InMyPajamas/breadboard-bench/out/plates/PLATES.md

# Plates — Bambu Studio projects, one per stage

Generated by `python cad/plates.py`. Each `.3mf` opens with the H2S
0.4 machine, the 0.20mm Standard process and the plate's filament
already selected, every part in its gated print pose, and per-object
wall / infill / brim overrides applied.

## Verified through Studio — and three things to still eyeball

These projects are written directly rather than exported by Studio.
`python cad/plates.py --verify` slices every one through Studio's own
CLI and checks walls / infill / brim in the G-code it produces; the
last run is recorded at the end of this file. (It runs on the macOS
build and on Windows from 02.08; the 02.07 Windows CLI returned −2/−3
with no output.) A slice proves the *CLI* accepts the file and keeps
its settings. It proves nothing about the GUI, which loads the named
system preset and re-applies only the keys listed in
`different_settings_to_system` — plate 01 once opened at the stock
2 walls / 15% grid while the CLI sliced it at 3 / 100%. Nor can it
look at the arrangement for you, so on first open:

1. Open `01_tpu_regime.3mf`. Fifteen objects should land in one row.
   That is the canary for *does Studio accept the file at all*.
2. Open `06_din_rail.3mf` and read the right-hand sidebar: it must say
   **5 walls, 25% infill, brim outer-only 5 mm**. That is the canary
   for *did the settings survive the load* — the one part where a
   silent reset to the stock 2-wall default would actually cost you.
3. On `04_first_article_a.3mf`, right-click `rear_tie` → object
   settings. It should carry its own brim. That is the canary for
   *per-object overrides*.

If any of the three is wrong, say so — the generator is one file
(`cad/plates.py`) and a re-run is seconds. Two of its rules exist
because Studio 2.8 rejected the first cut: the header keys a preset
carries (`description`, `filament_id`) must not reach a project as
vectors, and solid parts must use `zig-zag` infill — `rectilinear` is
no longer a value 2.8 recognises and `grid` is refused at 100%.

A plate's own process is set to the most demanding structural regime
on it, and object overrides only relax from there — so a missed
override over-builds a part, it never under-builds one. Check the
override column against the object list in Studio before slicing.

## Contradictions these plates had to settle

Building a real plate forces a decision where two documents disagree.
Three did:

- **DIN rail brim.** README's per-part table says brim `no`; the build
  plan's stage 6 note says `5 mm brim`. The build plan is the working
  document, so the rail gets the brim.
- **Plate size.** README says the H2S plate is 350 × 320. The machine
  profile's own `printable_area` is **340 × 320**; packing uses 340.
- **Stage 9 weight.** The build plan's stage header says 91 g, but its
  own file list (19 + 39 + 16 + 16 + 18) sums to 108. The plate is
  108 g. The header is the error.

## 01 — TPU regime and every pad

*Stage 1 · TPU · 11 objects · 7 g solid-equivalent · packs into 242 × 20 mm*

**Proves:** FOOT_FIT, and how much TPU for AMS actually over-prints here.

Plate process: **3 walls · 100% infill · brim off**

| object | qty | walls | infill | brim | override |
|---|---|---|---|---|---|
| `tpu_block` | 1 | 3 | 100% | no | plate |
| `foot_pad_006` | 2 | 3 | 100% | no | plate |
| `foot_pad_012` | 2 | 3 | 100% | no | plate |
| `foot_pad_018` | 2 | 3 | 100% | no | plate |
| `foot_pad` | 4 | 3 | 100% | no | plate |

**By hand in Studio:**

1. Rail gaskets retired 2026-10-05: the four printed TPU rail pads this plate carried are replaced by eight bought 3 x 1 O-rings (plate 02c). The plate is printed history; the pads are gone from the build so the record stays and the object goes.
2. Run the roll through the AMS in the OUTERMOST slot -- shortest, straightest PTFE run.
3. Chamber heater OFF. Nothing on this plate wants heat soak.
4. No brim: on a 6 mm-wide pad a brim is worse than none.

## 02 — PLA gauges

*Stage 2 · PLA · 10 objects · 120 g solid-equivalent · packs into 291 × 134 mm*

**Proves:** Every PLA fit in the build, on 3-53 g parts instead of 21-87 g.

Plate process: **5 walls · 25% infill · brim off**

| object | qty | walls | infill | brim | override |
|---|---|---|---|---|---|
| `fit_coupon_frame` | 1 | 3 | 15% | no | wall_loops=3, sparse_infill_density=15% |
| `rail_stub` | 1 | 5 | 25% | no | plate |
| `ladder_station_stub` | 1 | 3 | 15% | no | wall_loops=3, sparse_infill_density=15% |
| `pilot_block` | 1 | 5 | 25% | no | plate |
| `foot_gauge` | 1 | 3 | 15% | no | wall_loops=3, sparse_infill_density=15% |
| `spigot_stub` | 1 | 3 | 15% | no | wall_loops=3, sparse_infill_density=15% |
| `tie_stub` | 1 | 3 | 15% | no | wall_loops=3, sparse_infill_density=15% |
| `rail_cap_615` | 1 | 3 | 100% | no | wall_loops=3, sparse_infill_density=100%, sparse_infill_pattern=zig-zag |
| `rail_cap_625` | 1 | 3 | 100% | no | wall_loops=3, sparse_infill_density=100%, sparse_infill_pattern=zig-zag |
| `rail_cap_635` | 1 | 3 | 100% | no | wall_loops=3, sparse_infill_density=100%, sparse_infill_pattern=zig-zag |

**By hand in Studio:**

1. rail_stub and pilot_block are set to the DIN rail's 5 walls / 25% on purpose -- a stub in the gauge regime cannot predict the rail.
2. Write every measured number down before slicing anything in stage 4.

## 02b — Plate 02 follow-up: rail stub lips-down, foot gauge v2

*Stage 2 · PLA · 2 objects · 21 g solid-equivalent · packs into 178 × 35 mm*

**Proves:** That the flipped pose prints a clean lip: plate 02's stub printed web-down and sagged strands off both lips.

Plate process: **5 walls · 25% infill · brim off**

| object | qty | walls | infill | brim | override |
|---|---|---|---|---|---|
| `rail_stub` | 1 | 5 | 25% | no | plate |
| `foot_gauge_v2` | 1 | 3 | 15% | no | wall_loops=3, sparse_infill_density=15% |

**By hand in Studio:**

1. FOOT GAUGE v2: no pad of the 006/012/018 trio would enter v1's 16.00 x 6.00 pockets, so the pocket is the variable. Five pockets, +0.10 to +0.50 on length and width, tagged 1-5 dimples. Test with a PRODUCTION pad (caliper it: 16.24 x 6.24), groove in, thumb only, then invert and shake. The winner is the smallest pocket that passes both.
2. RAIL STUB: lips on the bed, web up. No support, no brim.
3. Caliper the lip band before the slot test: 34.85 wide, 1.20 thick, the same at both ends and the middle.
4. Then rerun test 2 (rail slots), and keep this stub for the stage 3 clips -- they hook the same lips.

## 02l — Half-bay gauge: the small board's 100 mm of the real ladder

*Stage 2 · PLA · 1 objects · 27 g solid-equivalent · packs into 89 × 100 mm*

**Proves:** That the half board drops into ITS bay: datum pocket and peg at 198.19, slot at 251.70, the rear shoulder stepped out 0.8 for the narrower board. Cut from frame.py's deck_ladder, so it is exactly what plate 07 prints there.

Plate process: **3 walls · 15% infill · brim off**

| object | qty | walls | infill | brim | override |
|---|---|---|---|---|---|
| `half_bay_gauge` | 1 | 3 | 15% | no | plate |

**By hand in Studio:**

1. Drop the HALF board straight down: one tab into the exact pocket near the left end of the gauge, the other into the slot, its notch over the peg on the far rail. Do not slide.
2. Pass: rim down on the shelf both sides, no rock, about 0.4 of play across, a shove along the rail meets the pocket wall.
3. If it sits off-centre along the rail that is the unmeasured end-to-cleat distance, not a fault; note which way and how far.
4. Lies along Y with Seam position = Back, like the ladder.

## 02r — Rail stub on its own: the clip target for plate 03

*Stage 2 · PLA · 1 objects · 11 g solid-equivalent · packs into 40 × 35 mm*

**Proves:** Nothing new: a fresh 40 mm slice of the real DIN rail to snap plate 03's clips onto. The 02b stub was thrown away.

Plate process: **5 walls · 25% infill · brim off**

| object | qty | walls | infill | brim | override |
|---|---|---|---|---|---|
| `rail_stub` | 1 | 5 | 25% | no | plate |

**By hand in Studio:**

1. Lips on the bed, web up. No support, no brim. About 15 minutes.
2. It carries the rail's new M3 cap-head counterbores at one end; they are irrelevant to the clip test.
3. Hook each plate 03 clip over one lip and rock it down. One clip at a time: the stub is 40 long and a clip is 30 wide.

## 02c — O-ring rail gasket test

*Stage 2 · PLA · 1 objects · 14 g solid-equivalent · packs into 12 × 64 mm*

**Proves:** Whether a 3 x 1 mm O-ring around each rail screw can replace the printed TPU gasket, and how deep its gland must be: the TPU on hand (TPU for AMS, ~68D) is too hard to squash.

Plate process: **5 walls · 25% infill · brim off**

| object | qty | walls | infill | brim | override |
|---|---|---|---|---|---|
| `pilot_block_oring` | 1 | 5 | 25% | no | plate |

**By hand in Studio:**

1. Station 1 (one dimple): gland 0.80 deep, 20% squeeze. Station 2 (two dimples): 0.70 deep, 30%.
2. One 3 x 1 O-ring flat in the gland around each pilot, the rail_stub from plate 02b over them, two M3x16 csk driven alternately by hand.
3. Pass: the stub's web pulls down flat (0.05 feeler will not enter), backing one screw out a turn lifts the web, and the pilots still bite after three cycles. The winner becomes RAIL_PAD_D in frame.py.

## 02d — Two deck stations, and the stops to hold a board

*Stage 2 · PLA · 1 objects · 47 g solid-equivalent · packs into 178 × 89 mm*

**Proves:** Whether a board sits FLAT across two supports, and whether the ladder's 2 mm indexing teeth catch a deck stop at all -- they print as a ~0.4 mm ripple because their tips are thinner than one extrusion line.

Plate process: **3 walls · 15% infill · brim off**

| object | qty | walls | infill | brim | override |
|---|---|---|---|---|---|
| `deck_pair` | 1 | 3 | 15% | no | plate |

**By hand in Studio:**

1. Deck stops retired 2026-09-23: the board's own cleats locate it now (plates 02e-02k). This plate is printed history; its stops are gone from the build so the record stays and the object goes.
2. deck_pair is the real deck_ladder trimmed to its first two stations (plates centred 51 and 141), so every tooth and ledge is exactly what plate 07 will print.
3. The deck stops are PETG in the real build; printed here in PLA on purpose, to avoid a material swap. Tooth engagement is what is being tested, not the clip's flex.
4. Set a full-size board across both stations: it must sit flat with no rock. Then push a stop along the strip -- you should feel a step every 2 mm and it should resist a shove.
5. If the stop slides freely, the teeth need redrawing before plate 07, or replacing with sockets for the board's own cleats (4.42 wide, 2.09 proud, about 65 mm apart).

## 02e — Tooth gauge: how blunt does a tooth need to be?

*Stage 2 · PLA · 4 objects · 12 g solid-equivalent · packs into 138 × 46 mm*

**Proves:** Plate 02d's teeth barely catch and barely stand up. Same 2.0 pitch and 0.9 depth on all three strips; only the flat on top of each tooth changes.

Plate process: **3 walls · 15% infill · brim off**

| object | qty | walls | infill | brim | override |
|---|---|---|---|---|---|
| `tooth_gauge` | 1 | 3 | 15% | no | plate |
| `tooth_rider_1` | 1 | 3 | 15% | no | plate |
| `tooth_rider_2` | 1 | 3 | 15% | no | plate |
| `tooth_rider_3` | 1 | 3 | 15% | no | plate |

**By hand in Studio:**

1. 1 dot = flat 0.0, the profile drawn today (the control). 2 dots = 0.6, about 1.4 extrusion lines across the tip. 3 dots = 0.9, about 2.1 lines.
2. Each rider is the negative of its OWN strip, with the same 0.1 clearance frame.py uses. Match the dimples: rider 2 on strip 2.
3. Slide each rider along its strip. You want a felt step every 2 mm, a rider that resists a shove, and teeth that do not fold over when you push sideways on them.
4. The winner becomes TOOTH_TOP in frame.py. Both halves of the real joint call teeth(), so one change fixes the ladder and the deck stop together.

## 02f — Slot gauge: slide the board in by its own tab

*Stage 2 · PLA · 3 objects · 13 g solid-equivalent · packs into 196 × 6 mm*

**Proves:** Whether a slot down the rail can replace the indexing teeth entirely. The board's edge tab slides in and the slot's ROOF stops it lifting -- a 5.2 mm feature doing the work instead of a 0.9 mm tooth that prints short and folds.

Plate process: **3 walls · 15% infill · brim off**

| object | qty | walls | infill | brim | override |
|---|---|---|---|---|---|
| `slot_gauge_1` | 1 | 3 | 15% | no | plate |
| `slot_gauge_2` | 1 | 3 | 15% | no | plate |
| `slot_gauge_3` | 1 | 3 | 15% | no | plate |

**By hand in Studio:**

1. Slot heights against a 5.20 tab: 1 dot 5.4, 2 dots 5.6, 3 dots 5.8. Depth is 2.5 on all three against a 2.09 tab.
2. Slide a board's TAB edge into each from the end -- it cannot be dropped in from above, that is the whole point.
3. Wanted: slides without forcing, no slop up and down, and the board cannot be lifted out. Then hold the gauge and let the board hang from it -- does the slot carry it?
4. The winner sets the slot height for deck_rail. Tab spacing does not matter: the slot runs the full length, so the board can stop anywhere.

## 02g — Cradle gauge: drop the board in by its own tab and notch

*Stage 2 · PLA · 3 objects · 19 g solid-equivalent · packs into 88 × 65 mm*

**Proves:** The gap between the rails, for a board that DROPS IN rather than slides: one rail carries an open pocket its tab falls into, the other a peg that falls into the notch opposite.

Plate process: **3 walls · 15% infill · brim off**

| object | qty | walls | infill | brim | override |
|---|---|---|---|---|---|
| `cradle_gauge_1` | 1 | 3 | 15% | no | plate |
| `cradle_gauge_2` | 1 | 3 | 15% | no | plate |
| `cradle_gauge_3` | 1 | 3 | 15% | no | plate |

**By hand in Studio:**

1. One station each. Gaps against the board's 54.74 plain width: 1 dot 54.94, 2 dots 55.14, 3 dots 55.34.
2. Drop a board straight down into each, lining the tab up with the open pocket and the notch with the peg.
3. Wanted: drops in without forcing, does not rattle sideways, and cannot slide along once seated.
4. Neither feature holds the board DOWN -- both locate it and gravity does the rest. Judge whether that is enough.
5. The winner sets the rail gap. Then a skeletal full-length piece checks that two or three stations line up at once.

## 02h — Span gauge, and how wide a peg the notch will take

*Stage 2 · PLA · 1 objects · 8 g solid-equivalent · packs into 124 × 12 mm*

**Proves:** Which station spacing the board's tabs really sit at. With discrete pockets this decides everything -- a pocket is 4.37 wide, so 2 mm out and the second tab misses. Only a photo estimate of 69-71 exists.

Plate process: **3 walls · 15% infill · brim off**

| object | qty | walls | infill | brim | override |
|---|---|---|---|---|---|
| `peg_gauge` | 1 | 3 | 15% | no | plate |

**By hand in Studio:**

1. PRINTED 2026-09-20, and its span strips were WRONG -- all four bracketed 68.58 to 72.39 when the board's cleats sit at about 66.04. They have been re-cut on plate 02i. Only peg_gauge remains here, and its answer stands: PEG_W = 3.8.
2. Drop the board's TAB edge onto each strip. Only the one whose spacing matches will take both tabs at once; the others will seat one and miss the other.
3. If two strips both take it, the board has slop -- say which felt tighter.
4. Nothing but two pads and a spine on purpose: the least material that can hold two pockets a fixed distance apart.
5. peg_gauge rides along: five pegs 3.2 to 4.0 wide, 1 to 5 dimples. Lower a board's NOTCH edge onto each. The widest that drops in cleanly is the peg width -- and it shows where the notch's mouth really is, which is the one dimension on that side still being assumed.

## 02i — Cleat rework: the fixed cradle, and the span re-cut to 66.04

*Stage 2 · PLA · 7 objects · 31 g solid-equivalent · packs into 262 × 78 mm*

**Proves:** Everything still open on board retention, on one plate. 02g's cradles were severed by their own tape relief and printed as two loose rails; 02h's spans were all too wide, bracketing 68.58-72.39 when the board sits at 66.04.

Plate process: **3 walls · 15% infill · brim off**

| object | qty | walls | infill | brim | override |
|---|---|---|---|---|---|
| `cradle_gauge_1` | 1 | 3 | 15% | no | plate |
| `cradle_gauge_2` | 1 | 3 | 15% | no | plate |
| `cradle_gauge_3` | 1 | 3 | 15% | no | plate |
| `span_gauge_1` | 1 | 3 | 15% | no | plate |
| `span_gauge_2` | 1 | 3 | 15% | no | plate |
| `span_gauge_3` | 1 | 3 | 15% | no | plate |
| `span_gauge_slot` | 1 | 3 | 15% | no | plate |

**By hand in Studio:**

1. This plate replaces 02g and 02h. Do not print either of those: 02g was severed, 02h's spacing was wrong.
2. CRADLES, 1 to 3 dots: rail gaps 54.94 / 55.14 / 55.34 against the board's 54.74 plain width. Drop a board straight down, tab into the open pocket, notch onto the peg. The tightest one that seats flush without rattling sets the rail gap.
3. Each cradle is now ONE piece. The first version cut its tape relief the full depth of the floor, which severed the two rails, and trimesh's is_watertight passed it because two disjoint closed solids are each watertight.
4. SPANS, 1 to 3 dots: 64.77 / 66.04 / 67.31, half a hole pitch apart, bracketing the measured 66.13. The board has THREE cleats per edge at about 66, not two at about 71.
5. span_gauge_slot is the production candidate and has no dots: its first pocket is exact, its second is slotted 63.04 to 69.04. One pocket locates, the other only stops rotation, so a spacing error stops mattering. Notches across its top face mark every half hole pitch -- read off where the second tab lands and that IS the spacing, no caliper needed.
6. If the slotted one seats easily and a graded one does not, that settles the design: slot the second pocket and stop chasing the constant.

## 02j — Span, re-cut to the calipered 65.21

*Stage 2 · PLA · 4 objects · 12 g solid-equivalent · packs into 254 × 18 mm*

**Proves:** The last open constant. 02i's spans were cut around 66.04, off a photo; the caliper says 65.21, so none of them could fit. These bracket the real number 0.5 mm apart.

Plate process: **3 walls · 15% infill · brim off**

| object | qty | walls | infill | brim | override |
|---|---|---|---|---|---|
| `span_gauge_1` | 1 | 3 | 15% | no | plate |
| `span_gauge_2` | 1 | 3 | 15% | no | plate |
| `span_gauge_3` | 1 | 3 | 15% | no | plate |
| `span_gauge_slot` | 1 | 3 | 15% | no | plate |

**By hand in Studio:**

1. Pocket centres: 1 dot 64.71, 2 dots 65.21 (the caliper reading), 3 dots 65.71. Half a millimetre apart, because a pocket only has 0.3 of slack -- a coarser step cannot tell the right answer from a near miss.
2. Drop the board's TAB edge straight down so both tabs go for both pockets at once. Do not slide it along.
3. span_gauge_slot has no dots and is the production candidate: its first pocket is exact, its second slotted 62.21 to 68.21. One pocket locates the board, the other only stops it rotating, so a spacing error is absorbed rather than jamming the first tab.
4. Notches across the slotted pad's top face mark every half hole pitch; the deep one is 65.21. Where the second tab lands IS the spacing -- read it off instead of calipering again.
5. If the slotted strip seats and a graded one does not, that settles the design: slot the second pocket in deck_rail and stop chasing the constant.

## 02k — Ledge gauge: the recessed deck, one datum station and one slot

*Stage 2 · PLA · 1 objects · 33 g solid-equivalent · packs into 120 × 89 mm*

**Proves:** Storyboard panel 28 in plastic. The first 120 mm of the proposed deck -- both rails with their ledges cut down 1.2, the datum pocket and peg, the slot at station 2 and the plate at 52 -- so the real board can be dropped on it before frame.py is touched.

Plate process: **3 walls · 15% infill · brim off**

| object | qty | walls | infill | brim | override |
|---|---|---|---|---|---|
| `ledge_gauge` | 1 | 3 | 15% | no | plate |

**By hand in Studio:**

1. Built on the Mac from PLAN.md's numbers (cad/ledge_gauge.py), not exported from frame.py: it tests the design. The station stub coupon, cut from frame.py later, tests the code.
2. Drop the full board's LEFT end straight down: first tab into the pocket near the left end, second tab into the slot, notch over the peg on the far rail. Do not slide it along.
3. Pass: rim down on the 0.6 shelf both sides with no rock, tape clear of the relief floor and the plate, about 0.4 of play across, and a shove along the rail meets the pocket wall, not friction.
4. Nothing stands above the rail crown. If anything on a ledge reads as a wall, that is a build error, not the design.
5. Tap the result into ledge.html on the Checks tab.

## 02m — Camera calibration target: dot grid and staircase

*Stage 2 · PLA · 3 objects · 37 g solid-equivalent · packs into 226 × 90 mm*

**Proves:** Turns the 4K top-down camera into a measuring instrument: 84 dark dots on a 10 mm pitch at mat level for scale, tilt and lens distortion, and two drop-in cups that put dots at 5 and 20 mm for the camera height and lens centre. The side camera reads the step faces for its height scale.

Plate process: **3 walls · 15% infill · brim off**

| object | qty | walls | infill | brim | override |
|---|---|---|---|---|---|
| `cal_target` | 1 | 3 | 15% | no | plate |
| `cal_step5` | 1 | 3 | 15% | no | plate |
| `cal_step20` | 1 | 3 | 15% | no | plate |

**By hand in Studio:**

1. Print it in a LIGHT colour -- the holes work by showing the dark mat through them. Black PLA makes it useless.
2. Three flat parts, no bridges, no supports: the plate, and two open cups printed floor-down. After printing, flip each cup and drop it into its recess on the plate, open side down -- the short one at the left end, the tall one at the right. Their dotted faces then sit 5 and 20 mm above the plate.After printing, caliper the plate's long side (nominal 140.00) and its short side (90.00) and tap them into the sheet: the true pitch is scaled from those, everything else follows.
3. Lay it flat on the mat near the centre under the overhead camera, marker hole at the top right, and take one Screenshot (Source) at 4K. Then one shot where the side camera sees the staircase edge-on.

## 03 — PETG gauges

*Stage 3 · PETG · 2 objects · 39 g solid-equivalent · packs into 230 × 26 mm*

**Proves:** RAIL_FIT for clips, the latch chamfer decision, MAGNET_FIT.

Plate process: **3 walls · 15% infill · brim off**

| object | qty | walls | infill | brim | override |
|---|---|---|---|---|---|
| `fit_clips_petg` | 1 | 3 | 15% | no | plate |
| `magnet_gauge` | 1 | 3 | 15% | no | plate |

**By hand in Studio:**

1. Supports are ALREADY PAINTED on fit_clips_petg: under each clip's tooth and release tab, written into the file. Support is normal(manual), so nothing else is generated. Just slice; the preview should show a thin column inside each of the four clips and none on the magnet gauge.
2. PLA SUPPORT INTERFACE, three clicks (the file cannot carry it yet): 1. In Project Filaments click + and pick your PLA. 2. Process > Support > Support/raft interface: choose filament 2. 3. Studio offers to set the matching zero-gap settings: click Yes. PLA does not bond to PETG, so the tooth and tab faces come out clean. Expect a prime tower and about 2h 45m.
3. A filled relief slot is a dead latch. It has happened twice.

## 04 — First article A -- left frame, tie, caps

*Stage 4 · PLA · 4 objects · 49 g solid-equivalent · packs into 294 × 189 mm*

**Proves:** The first structural parts, and the mating part everything later needs.

Plate process: **4 walls · 25% infill · brim off**

| object | qty | walls | infill | brim | override |
|---|---|---|---|---|---|
| `end_frame` | 1 | 3 | 15% | no | wall_loops=3, sparse_infill_density=15% |
| `rear_tie` | 1 | 4 | 25% | no | plate |
| `rail_cap` | 2 | 3 | 100% | no | wall_loops=3, sparse_infill_density=100%, sparse_infill_pattern=zig-zag |

**By hand in Studio:**

1. Three regimes on one plate. Check each object's overrides in the object list before slicing (see the table below).
2. Do not slice end_frame_r until every check on this plate has passed.

## 05 — Right frame -- the mirror export

*Stage 5 · PLA · 1 objects · 27 g solid-equivalent · packs into 60 × 165 mm*

**Proves:** The mirror export, and closes the pair.

Plate process: **3 walls · 15% infill · brim off**

| object | qty | walls | infill | brim | override |
|---|---|---|---|---|---|
| `end_frame_r` | 1 | 3 | 15% | no | plate |

**By hand in Studio:**

1. end_frame_r is a genuinely different STL, not the same file twice. Its pose is Y+90 where the left frame is Y-90.

## 06 — The DIN rail

*Stage 6 · PLA · 1 objects · 74 g solid-equivalent · packs into 300 × 35 mm*

**Proves:** The first big part. Nothing downstream can compensate if it warps.

Plate process: **5 walls · 25% infill · brim off**

| object | qty | walls | infill | brim | override |
|---|---|---|---|---|---|
| `din_rail` | 1 | 5 | 25% | no | plate |

**By hand in Studio:**

1. Only print this after both frames have accepted the stub.
2. Same flow and seam settings the stage 2 stub used.

## 04x — Both end frames, reprinted with a solid post

*Stage 4 · PLA · 2 objects · 54 g solid-equivalent · packs into 132 × 165 mm*

**Proves:** Nothing new: the frames from plate 06x flexed at the post's lightening window (3 mm ribs over an 18 mm opening), so the window is closed and both frames print again (2026-10-08).

Plate process: **3 walls · 15% infill · brim off**

| object | qty | walls | infill | brim | override |
|---|---|---|---|---|---|
| `end_frame` | 1 | 3 | 15% | no | plate |
| `end_frame_r` | 1 | 3 | 15% | no | plate |

**By hand in Studio:**

1. Outer face down, no brim. Everything else from plate 06x (tie, caps, rail) is already printed and stays.

## 06x — Both frames, the tie, both caps and the rail -- one plate

*Stage 6 · PLA · 6 objects · 150 g solid-equivalent · packs into 300 × 267 mm*

**Proves:** Nothing new: plates 04, 05 and 06 together, because the user asked for the PLA Matte parts on one bed (2026-10-07). Same per-object walls and infill as the separate plates.

Plate process: **5 walls · 25% infill · brim off**

| object | qty | walls | infill | brim | override |
|---|---|---|---|---|---|
| `end_frame` | 1 | 3 | 15% | no | wall_loops=3, sparse_infill_density=15% |
| `end_frame_r` | 1 | 3 | 15% | no | wall_loops=3, sparse_infill_density=15% |
| `rear_tie` | 1 | 4 | 25% | no | wall_loops=4 |
| `rail_cap` | 2 | 3 | 100% | no | wall_loops=3, sparse_infill_density=100%, sparse_infill_pattern=zig-zag |
| `din_rail` | 1 | 5 | 25% | no | plate |

**By hand in Studio:**

1. This breaks the stop rule 'one of each part before its second copy' on purpose: if the left frame's mortise binds, the right frame is already printed too. Print plate 04 alone first if that risk matters more than the bed time.
2. The rail's eight counterbores carry a one-layer skin at the seat: push the M3x12 cap screw through it.
3. No brim anywhere. The frames print on their outer face, the rail lips-down, the caps top-face down.

## 07 — The deck ladder

*Stage 7 · PLA · 1 objects · 78 g solid-equivalent · packs into 89 × 294 mm*

**Proves:** Largest single print. Gated on board width, socket clearance and the tie's shrink.

Plate process: **3 walls · 15% infill · brim off**

| object | qty | walls | infill | brim | override |
|---|---|---|---|---|---|
| `deck_ladder` | 1 | 3 | 15% | no | plate |

**By hand in Studio:**

1. Shoulder to shoulder must read 288.00 and agree with the tie's shrink within 0.15.
2. The ladder lies along Y on purpose, with Seam position = Back: that puts every layer's seam at a rail end. Leave both alone; on Aligned the seams land in the board pockets.

## 07b — TPU production pads -- the 14 held back

*Stage 7 · TPU · 14 objects · 7 g solid-equivalent · packs into 305 × 6 mm*

**Proves:** Nothing. This is the balance of the 18 feet, released once FOOT_FIT is confirmed.

Plate process: **3 walls · 100% infill · brim off**

| object | qty | walls | infill | brim | override |
|---|---|---|---|---|---|
| `foot_pad` | 14 | 3 | 100% | no | plate |

**By hand in Studio:**

1. Do not print this until stage 2's foot_gauge has confirmed FOOT_FIT. If the constant moved, regenerate first.

## 07c — TPU pads for the side tray and side bin (4)

*Stage 7 · TPU · 4 objects · 2 g solid-equivalent · packs into 83 × 6 mm*

**Proves:** Nothing new: 07b's 14 went into the ladder, frames and rear tray; plate 01's 4 are not assumed to exist (user, 2026-10-09).

Plate process: **3 walls · 100% infill · brim off**

| object | qty | walls | infill | brim | override |
|---|---|---|---|---|---|
| `foot_pad` | 4 | 3 | 100% | no | plate |

**By hand in Studio:**

1. 2 under the side tray, 2 under the side bin, grooved face in.

## 07f — All 18 TPU feet, for a whole bench

*Stage 7 · TPU · 18 objects · 9 g solid-equivalent · packs into 305 × 18 mm*

**Proves:** 07b and 07c on one plate: the TPU file that goes with the whole-bench project (one project cannot hold a third filament yet).

Plate process: **3 walls · 100% infill · brim off**

| object | qty | walls | infill | brim | override |
|---|---|---|---|---|---|
| `foot_pad` | 18 | 3 | 100% | no | plate |

**By hand in Studio:**

1. Same regime as 07b: TPU 95A HF, slow walls, 4 top and bottom layers.
2. 14 go under the frames, ladder and tray; 4 under the side tray and bin.

## 08 — The rear tray

*Stage 8 · PLA · 1 objects · 65 g solid-equivalent · packs into 288 × 53 mm*

**Proves:** Last of the PLA structure, and the only part with a real cooling problem.

Plate process: **4 walls · 15% infill · brim off**

| object | qty | walls | infill | brim | override |
|---|---|---|---|---|---|
| `rear_tray` | 1 | 4 | 15% | no | plate |

**By hand in Studio:**

1. ~190 layers of two isolated fins. That is what the 8 s fan threshold and 100% part fan are for.
2. Before any rail screw: a csk dropped into each buttress pilot must stand at least 7.75 mm proud.

## 10m — Buried head-magnet coupons: how much skin still snaps

*Stage 10 · PETG · 2 objects · 7 g solid-equivalent · packs into 40 × 20 mm*

**Proves:** Whether a side magnet sealed in at a pause (0.3 head clearance + 0.45 / 0.65 / 0.85 skin) still docks the side parts, against today's open seat. Model: 29 / 25 / 22 % of contact pull.

Plate process: **3 walls · 15% infill · brim off**

| object | qty | walls | infill | brim | override |
|---|---|---|---|---|---|
| `skin_coupon_045` | 1 | 3 | 15% | no | plate |
| `skin_coupon_085` | 1 | 3 | 15% | no | plate |

**By hand in Studio:**

1. Pause at 8.0 mm is in the file. Drop one disc ON EDGE into the slot of each coupon (1 nub = 0.45 skin, 3 nubs = 0.85). Each must sit below the top. Resume.
2. Reference: the finished side tray / bin with its open seats.
3. Test: set each on the desk against a bar-end screw head on the frame and feel the snap; tug it off sideways.

## 03c — Two test clips: full-width latch at 1.8 and 2.0 mm

*Stage 3 · PETG · 2 objects · 14 g solid-equivalent · packs into 82 × 8 mm*

**Proves:** The 2026-10-10 latch: full clip width, 2.0 thick (~1.9% strain against the old ~10%). Snap on and off the rail stub many times; one to keep, one to abuse.

Plate process: **3 walls · 15% infill · brim off**

| object | qty | walls | infill | brim | override |
|---|---|---|---|---|---|
| `clip_test_18` | 1 | 3 | 15% | no | plate |
| `clip_test_20` | 1 | 3 | 15% | no | plate |

**By hand in Studio:**

1. Support paint is in the file (PETG support, no PLA): trim it off the tooth and the tab with a knife.
2. Test on the rail: rock on, lever off by the tab, twenty times. Should flex like a keyboard key and never whiten at the root.

## 10d — CrowPanel P4 backplate

*Stage 10 · PLA · 1 objects · 43 g solid-equivalent · packs into 181 × 109 mm*

**Proves:** The screen on the bench: four bolted corner bosses (pressed M3 nuts, rebuilt 2026-10-17 after the self-tap bosses split) take the panel's own M3 slots, two bars screw to the posts, and a dovetail socket on the top edge takes the mic crown (10c). Clearance to the tallest part on the board's back: 1.4 mm (Elecrow's STEP).

Plate process: **4 walls · 25% infill · brim off**

| object | qty | walls | infill | brim | override |
|---|---|---|---|---|---|
| `display_backplate` | 1 | 4 | 25% | no | plate |

**By hand in Studio:**

1. Back face down, no supports.
2. Press an M3 hex nut into the hex pocket in the back of each corner boss (4). A screw from the front and a few turns pulls a stiff one home.
3. On the TABLE, not the rail: posts face-up, clip feet hanging off the edge so the backs lie flat. Slide 2 M3 hex nuts down each post's channel from the top, under the holes.
4. Backplate onto the posts: 4 x M3 x 8 cap from the front, heads in the counterbores. Hook the unit onto the rail, rock it flat, and turn each post's snap lock wing (plate 10L) a quarter turn so it points along the post. Then the screen: 4 x M3 x 16 cap from the front through its corner slots into the boss nuts, snug only.

## 10c — Mic crown for the reSpeaker XVF3800

*Stage 10 · PETG · 1 objects · 46 g solid-equivalent · packs into 108 × 123 mm*

**Proves:** The mic array above the screen with no screws (2026-10-17): a dovetail tongue down the backplate's top socket, the board on three pads under its M2 holes, two fixed lips and one sprung lip on its edge, pins in two holes so it cannot turn.

Plate process: **4 walls · 40% infill · brim off**

| object | qty | walls | infill | brim | override |
|---|---|---|---|---|---|
| `mic_crown` | 1 | 4 | 40% | no | plate |

**By hand in Studio:**

1. Back face down, no supports. The lips' undersides are 1.5 mm overhangs; they print as they are.
2. Board in, logo face out: tuck its bottom edge under the two lower lips, lay it on the pads with the pins in its holes, press the top edge until the sprung lip clicks. Out: pull that lip's tab outward.
3. Crown on: tongue into the socket on the backplate's top edge, slide it down to the stop. It lifts straight back out.

## 09 — PETG side tray and side bin -- no supports, no PLA

*Stage 9 · PETG · 2 objects · 62 g solid-equivalent · packs into 74 × 161 mm*

**Proves:** Everything left is a repeat of a proven regime with settled constants.

Plate process: **3 walls · 15% infill · brim off**

| object | qty | walls | infill | brim | override |
|---|---|---|---|---|---|
| `side_tray` | 1 | 3 | 15% | no | plate |
| `side_bin` | 1 | 3 | 15% | no | plate |

**By hand in Studio:**

1. Pause 1 at 3.2 mm (in the file): 5 discs flat into the side tray's cells, 2 into the side bin's. Resume.
2. Pause 2 at 7.04 mm (in the file): 3 discs ON EDGE into each part's slots behind the head pockets (6 in all). Resume.
3. Nothing to fit after the print: every disc is sealed in.

## 09c — PETG clip parts: rail bin + both display posts

*Stage 9 · PETG · 3 objects · 51 g solid-equivalent · packs into 142 × 144 mm*

**Proves:** Both clip-on modules together: their interface windows sit at the same heights, so they share the PLA swaps.

Plate process: **4 walls · 40% infill · brim off**

| object | qty | walls | infill | brim | override |
|---|---|---|---|---|---|
| `rail_bin` | 1 | 3 | 15% | no | plate |
| `display_post` | 2 | 4 | 40% | no | wall_loops=4, sparse_infill_density=40% |

**By hand in Studio:**

1. Support paint is already in the file (PAINT table): the clip channels only.
2. PLA interface is already in the file (pla_template): PLA Basic in slot 2 at 230, bed 60, purge 223/450. Never press Sync info.
3. Both posts at once (user's call): watch the last hour, when only the two 144 mm posts are printing.

## 10p — Display posts with twist locks (replaces 09c's posts)

*Stage 10 · PETG · 6 objects · 37 g solid-equivalent · packs into 157 × 144 mm*

**Proves:** The screen unit stays on the rail under its own weight and a finger on the touchscreen: no spring latch, a quarter-turn twist lock under the lower lip instead (both latches broke, 2026-10-17).

Plate process: **4 walls · 40% infill · brim off**

| object | qty | walls | infill | brim | override |
|---|---|---|---|---|---|
| `display_post` | 2 | 4 | 40% | no | wall_loops=4, sparse_infill_density=40% |
| `display_lock` | 2 | 4 | 100% | no | wall_loops=4, sparse_infill_density=100%, sparse_infill_pattern=zig-zag |
| `display_lock_knob` | 2 | 4 | 100% | no | wall_loops=4, sparse_infill_density=100%, sparse_infill_pattern=zig-zag |

**By hand in Studio:**

1. Posts lie FRONT FACE DOWN (2026-10-17): layers run along the post, so the screen's lever bends them along the extrusions, not across them.
2. Support paint is already in the file: under the hook's tooth only.
3. PLA interface is already in the file, as on 09c. Never press Sync info.
4. Lock, no screws: push each lock's shaft through the foot's bore from behind, then press the wing down over the hex until it clicks.
5. Use: hook the post over the rail's top lip, rock it flat, turn the knob a quarter clockwise (knob along the post = locked).

## 10L — Screwless twist locks for the posts already printed

*Stage 10 · PETG · 4 objects · 4 g solid-equivalent · packs into 61 × 22 mm*

**Proves:** The lock with its own shaft and a snap-on wing: no M3 screw, no nut (2026-10-17, user: 'Less m3 screws the better'). Fits plate 10p's posts as printed -- same 3.8 bore.

Plate process: **4 walls · 100% infill · brim off**

| object | qty | walls | infill | brim | override |
|---|---|---|---|---|---|
| `display_lock` | 2 | 4 | 100% | no | plate |
| `display_lock_knob` | 2 | 4 | 100% | no | plate |

**By hand in Studio:**

1. No supports: the locks lie on their flat side, tooth up; the wings stand on their underside.
2. Push each lock's shaft through the foot's bore from behind, then press the wing down over the hex until it clicks. Wing along the post = locked; a quarter turn back = open.

## 11t — DIN tilt adapter, with its twist lock

*Stage 11 · PETG · 5 objects · 50 g solid-equivalent · packs into 145 × 53 mm*

**Proves:** A generic DIN device too tall for the raked rail (the UniFi UA-Hub-Door-Mini, 113 mm) clips onto a short TS35 stub stood 40 mm off the rail on a 24-tooth hinge, from the rail's angle to flat in 15-degree steps (2026-10-17).

Plate process: **4 walls · 40% infill · brim off**

| object | qty | walls | infill | brim | override |
|---|---|---|---|---|---|
| `din_tilt_base` | 1 | 4 | 40% | no | plate |
| `din_tilt_arm` | 1 | 4 | 40% | no | plate |
| `din_tilt_knob` | 1 | 4 | 100% | no | sparse_infill_density=100%, sparse_infill_pattern=zig-zag |
| `display_lock` | 1 | 4 | 100% | no | sparse_infill_density=100%, sparse_infill_pattern=zig-zag |
| `display_lock_knob` | 1 | 4 | 100% | no | sparse_infill_density=100%, sparse_infill_pattern=zig-zag |

**By hand in Studio:**

1. No supports: every part stands on an end face, profiles in the layer plane, hinge teeth facing up.
2. Hinge: press an M3 x 20's head down the well in the base's end into its seat (a drop of super glue if it spins), arm on, M3 nut pressed into the thumb knob, knob onto the screw. Loosen 3 turns to swing, retighten.
3. Lock: as on the display posts -- shaft through the foot from behind, wing pressed on until it clicks.

## 09p — The second display post

*Stage 9 · PETG · 1 objects · 16 g solid-equivalent · packs into 30 × 144 mm*

**Proves:** Repeat of 09c's post, once the first has stood.

Plate process: **4 walls · 40% infill · brim off**

| object | qty | walls | infill | brim | override |
|---|---|---|---|---|---|
| `display_post` | 1 | 4 | 40% | no | wall_loops=4, sparse_infill_density=40% |

**By hand in Studio:**

1. Support paint is already in the file: the clip channel only.
2. PLA interface is already in the file, as on 09c.

## Verified by Bambu Studio 02.08.02.61 — 2026-10-17

`python cad/plates.py --verify` sliced every plate through Studio's
own CLI and read walls / infill / brim back out of the exported
G-code. Weight and time are Studio's estimates for the whole plate.

| plate | rc | walls | infill | brim | filament | print time | result |
|---|---|---|---|---|---|---|---|
| 01 | 0 | 3 | 100% | no_brim | 7.02 g | 24m 57s | ok |
| 02 | 0 | 5 | 25% | no_brim | 87.76 g | 2h 8m 8s | ok |
| 02b | 0 | 5 | 25% | no_brim | 14.21 g | 21m 24s | ok |
| 02l | 0 | 3 | 15% | no_brim | 17.43 g | 29m 7s | ok |
| 02r | 0 | 5 | 25% | no_brim | 6.81 g | 9m 31s | ok |
| 02c | 0 | 5 | 25% | no_brim | 9.23 g | 13m 3s | ok |
| 02d | 0 | 3 | 15% | no_brim | 30.60 g | 48m 52s | ok |
| 02e | 0 | 3 | 15% | no_brim | 7.95 g | 14m 24s | ok |
| 02f | 0 | 3 | 15% | no_brim | 10.13 g | 15m 34s | ok |
| 02g | 0 | 3 | 15% | no_brim | 16.02 g | 25m 50s | ok |
| 02h | 0 | 3 | 15% | no_brim | 5.26 g | 10m 19s | ok |
| 02i | 0 | 3 | 15% | no_brim | 26.73 g | 43m 56s | ok |
| 02j | 0 | 3 | 15% | no_brim | 10.82 g | 18m 29s | ok |
| 02k | 0 | 3 | 15% | no_brim | 20.04 g | 32m 3s | ok |
| 02m | 0 | 3 | 15% | no_brim | 33.65 g | 1h 2m 39s | ok |
| 03 | 0 | 3 | 15% | no_brim | 37.57 g | 1h 14m 1s | ok |
| 04 | 0 | 4 | 25% | no_brim | 32.55 g | 52m 21s | ok |
| 05 | 0 | 3 | 15% | no_brim | 15.09 g | 24m 47s | ok |
| 06 | 0 | 5 | 25% | no_brim | 47.68 g | 1h 2m 54s | ok |
| 04x | 0 | 3 | 15% | no_brim | 30.05 g | 49m 16s | ok |
| 06x | 0 | 5 | 25% | no_brim | 94.97 g | 2h 18m 59s | ok |
| 07 | 0 | 3 | 15% | no_brim | 53.43 g | 4h 45m 38s | ok |
| 07b | 0 | 3 | 100% | no_brim | 7.23 g | 28m 55s | ok |
| 07c | 0 | 3 | 100% | no_brim | 2.12 g | 8m 27s | ok |
| 07f | 0 | 3 | 100% | no_brim | 9.14 g | 36m 42s | ok |
| 08 | 0 | 4 | 15% | no_brim | 59.96 g | 4h 12m 16s | ok |
| 10m | 0 | 3 | 15% | no_brim | 4.12 g | 12m 58s | ok |
| 03c | 0 | 3 | 15% | no_brim | 13.97 g | 47m 36s | ok |
| 10d | 0 | 4 | 25% | no_brim | 32.08 g | 48m 39s | ok |
| 10c | 0 | 4 | 40% | no_brim | 30.05 g | 44m 8s | ok |
| 09 | 0 | 3 | 15% | no_brim | 42.23 g | 2h 32m 5s | ok |
| 09c | 0 | 3 | 15% | no_brim | 70.19,9.73 g | 3h 3m 21s | ok |
| 10p | 0 | 3 | 15% | no_brim | 32.71,1.44 g | 1h 6m 25s | ok |
| 10L | 0 | 4 | 100% | no_brim | 3.87 g | 13m 55s | ok |
| 11t | 0 | 4 | 40% | no_brim | 34.06 g | 1h 7m 30s | ok |
| 09p | 0 | 3 | 15% | no_brim | 16.78,1.35 g | 37m 52s | ok |

## Projects: several plates in one Studio file

Slot 1 PETG HF, slot 2 PLA Basic (the saved two-filament template). Map them
in the Print dialog; do not press Sync info.

### `project_screen_mic_din.3mf` — Screen case, mic crown, DIN tilt adapter

| plate | from | material | carried per object | time | filament |
|---|---|---|---|---|---|
| 1 | 10d CrowPanel P4 backplate | PLA | - | 54 min | 30.75 g |
| 2 | 10c Mic crown for the reSpeaker XVF3800 | PETG | - | 49 min | 30.13 g |
| 3 | 11t DIN tilt adapter, with its twist lock | PETG | - | 1 h 13 | 34.14 g |

### `project_whole_bench.3mf` — The whole Breadboard Bench, PLA + PETG

| plate | from | material | carried per object | time | filament |
|---|---|---|---|---|---|
| 1 | 06x Both frames, the tie, both caps and the rail -- one plate | PLA | - | 2 h 24 | 90.88 g |
| 2 | 07 The deck ladder | PLA | layer_height=0.08, ironing_type=top, seam_position=back | 4 h 20 | 51.08 g |
| 3 | 08 The rear tray | PLA | layer_height=0.12, ironing_type=top | 3 h 59 | 57.33 g |
| 4 | 09 PETG side tray and side bin -- no supports, no PLA | PETG | layer_height=0.12 | 2 h 20 | 42.29 g |
| 5 | 10b Display posts, twist locks and the rail bin | PETG | - | 3 h 19 | 83.72 g |
| 6 | 10d CrowPanel P4 backplate | PLA | - | 54 min | 30.75 g |
| 7 | 10c Mic crown for the reSpeaker XVF3800 | PETG | - | 49 min | 30.13 g |
| 8 | 11t DIN tilt adapter, with its twist lock | PETG | - | 1 h 13 | 34.14 g |
