InMyPajamas/breadboard-bench/checklist/img/foot_pad.png

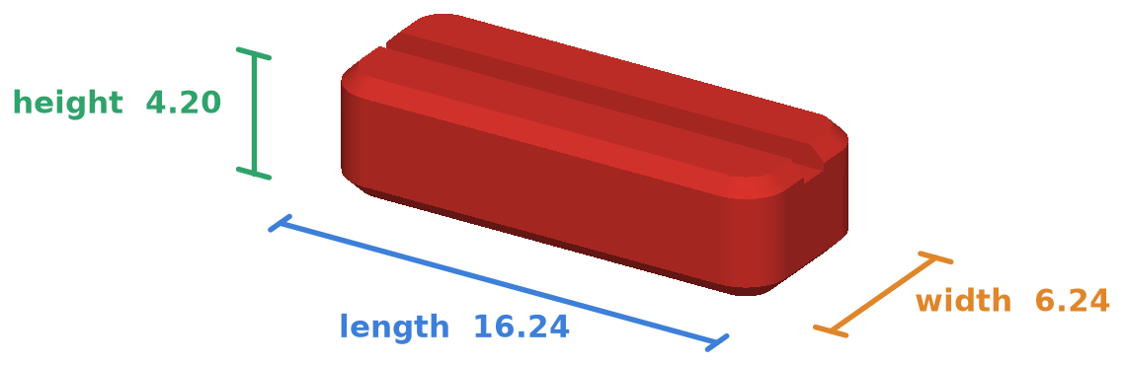
checklist/img/foot_pad.png
