InMyPajamas/breadboard-bench/checklist/img/part_cradle_gauge_1.png

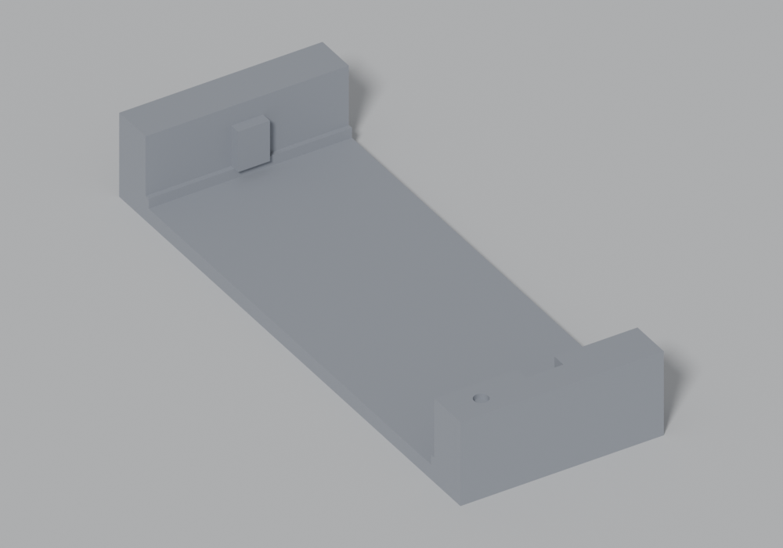
checklist/img/part_cradle_gauge_1.png
