InMyPajamas/breadboard-bench/checklist/img/part_fit_coupon_frame.png

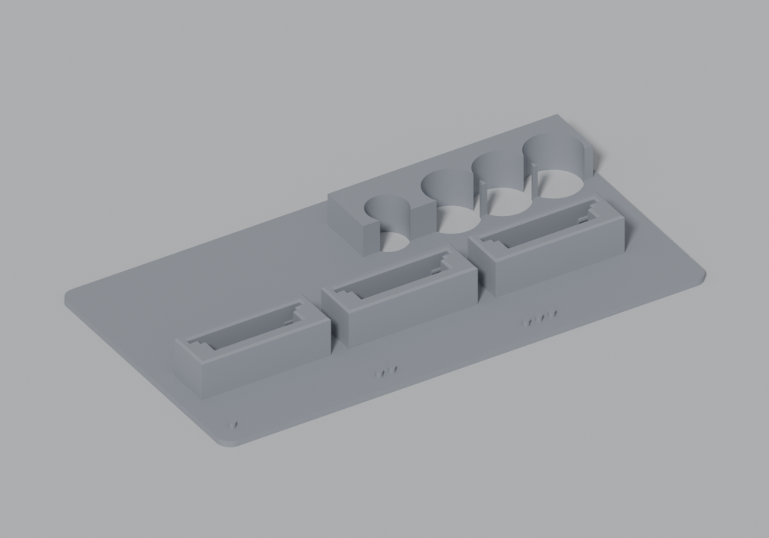
checklist/img/part_fit_coupon_frame.png
