InMyPajamas/breadboard-bench/checklist/img/part_foot_gauge.png

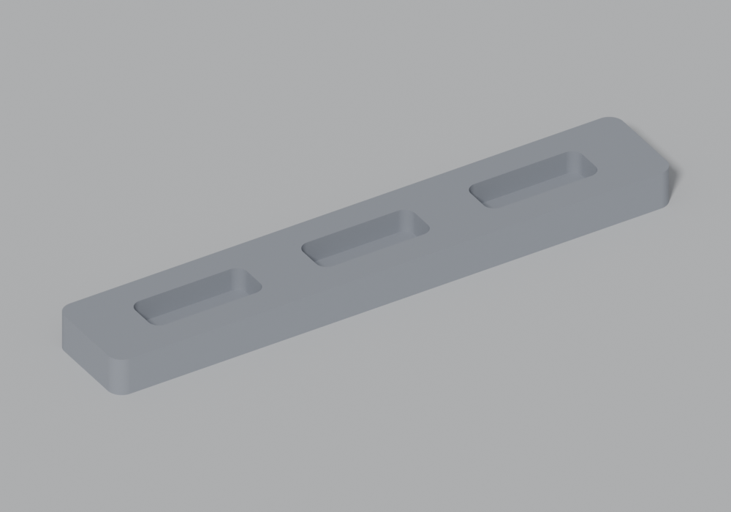
checklist/img/part_foot_gauge.png
