InMyPajamas/breadboard-bench/checklist/img/part_foot_gauge_v2.png

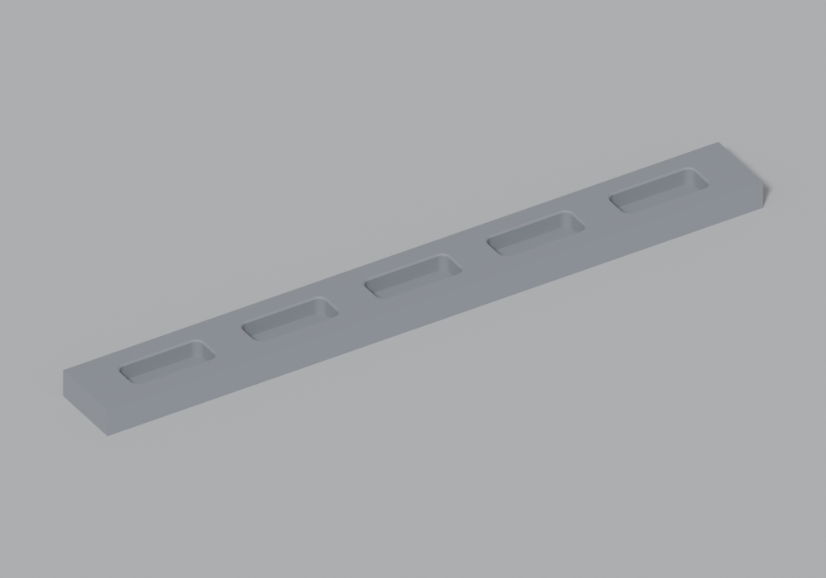
checklist/img/part_foot_gauge_v2.png
