InMyPajamas/breadboard-bench/checklist/img/part_foot_pad.png

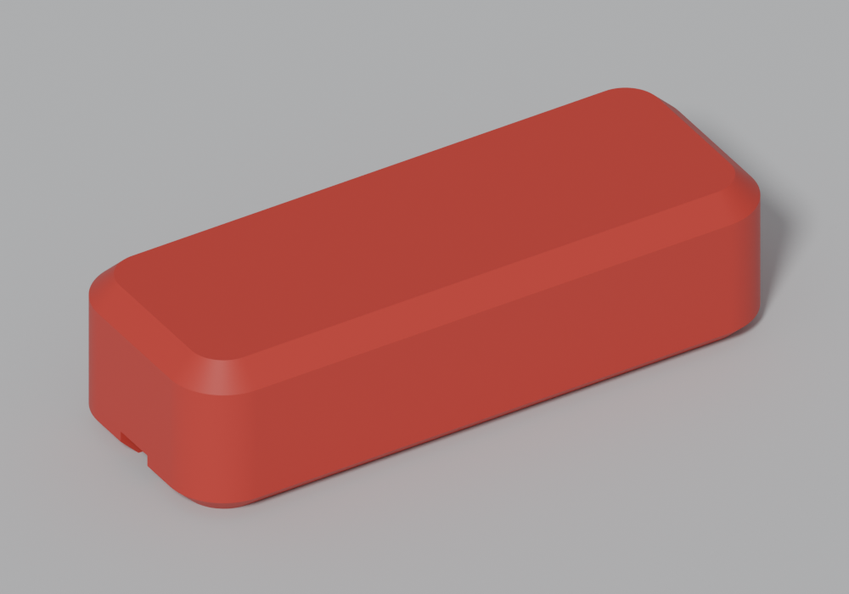
checklist/img/part_foot_pad.png
