InMyPajamas/breadboard-bench/checklist/img/part_ladder_station_stub.png

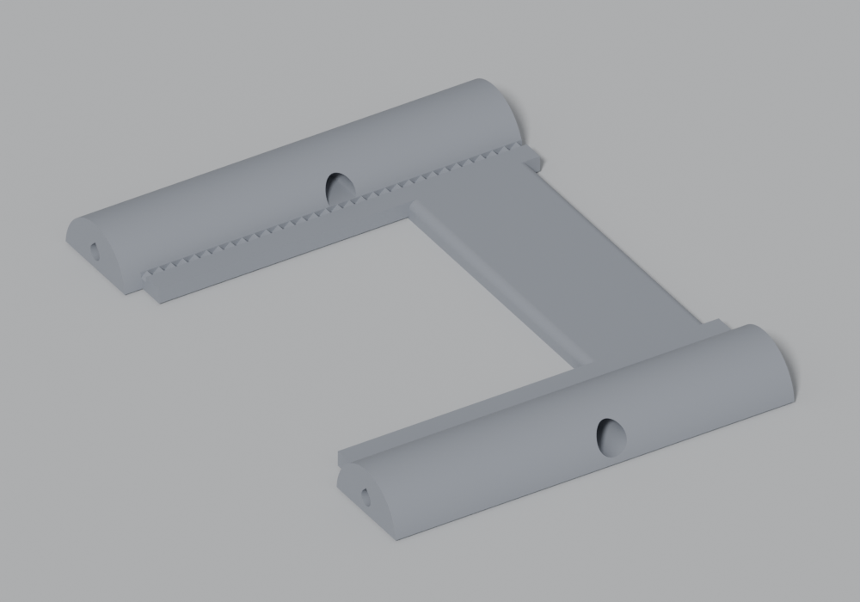
checklist/img/part_ladder_station_stub.png
