InMyPajamas/breadboard-bench/checklist/img/part_pilot_block.png

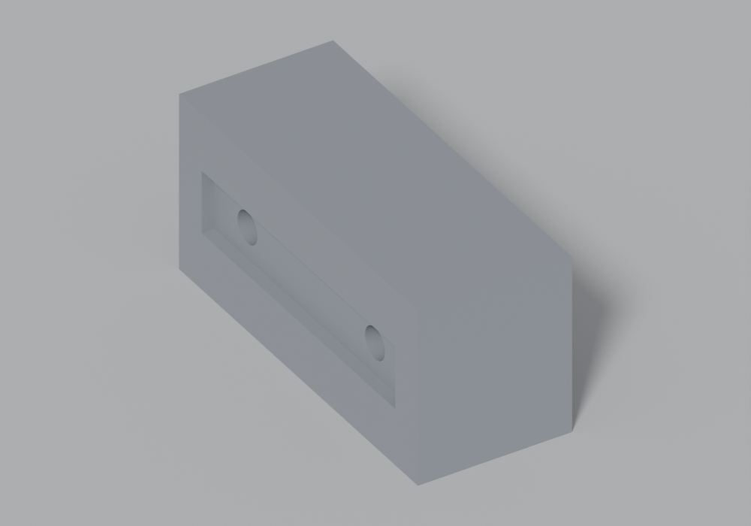
checklist/img/part_pilot_block.png
