InMyPajamas/breadboard-bench/checklist/img/part_rail_cap_615.png

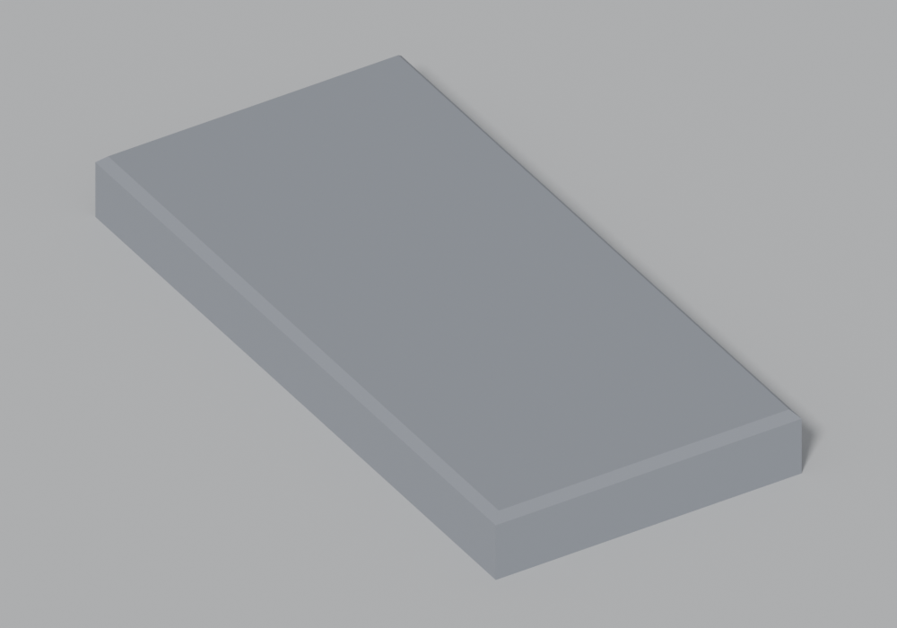
checklist/img/part_rail_cap_615.png
