InMyPajamas/breadboard-bench/checklist/img/part_rail_pad.png

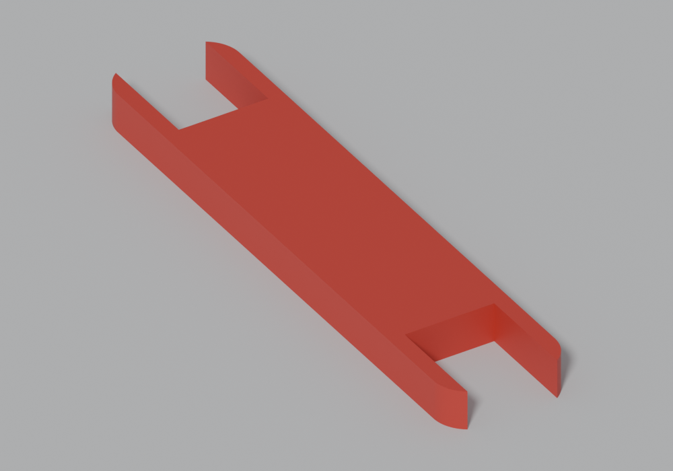
checklist/img/part_rail_pad.png
