InMyPajamas/breadboard-bench/checklist/img/part_rail_stub.png

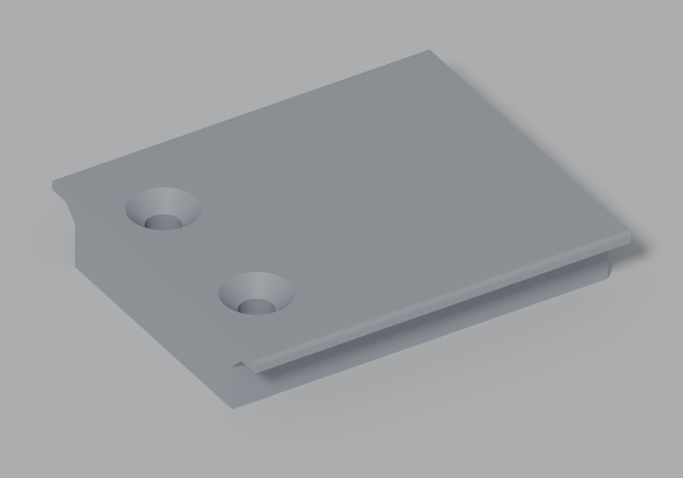
checklist/img/part_rail_stub.png
