InMyPajamas/breadboard-bench/checklist/img/part_slot_gauge_1.png

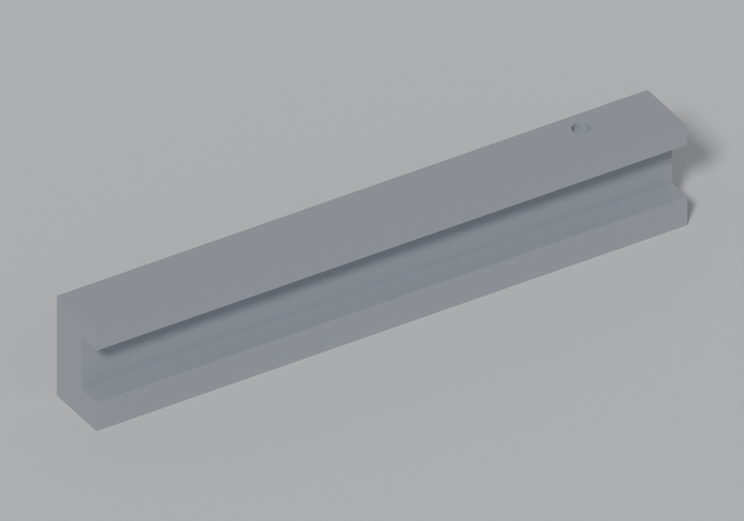
checklist/img/part_slot_gauge_1.png
