InMyPajamas/breadboard-bench/checklist/img/part_span_gauge_1.png

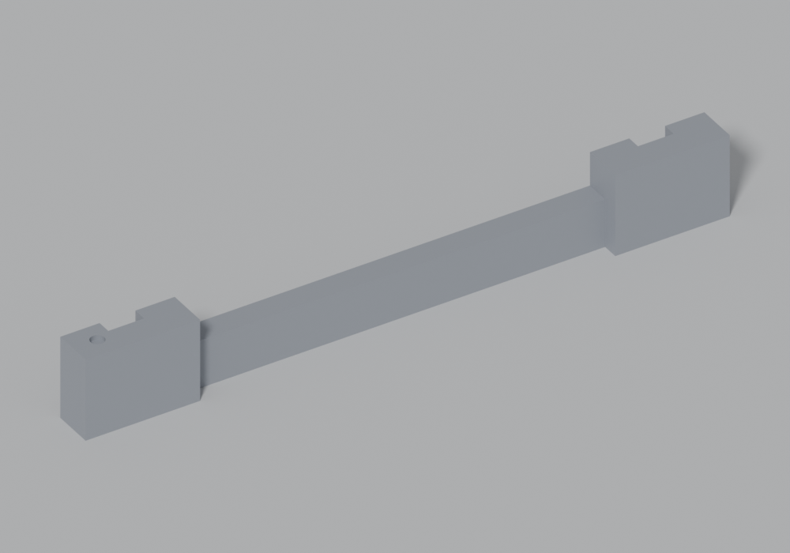
checklist/img/part_span_gauge_1.png
