InMyPajamas/breadboard-bench/checklist/img/part_spigot_stub.png

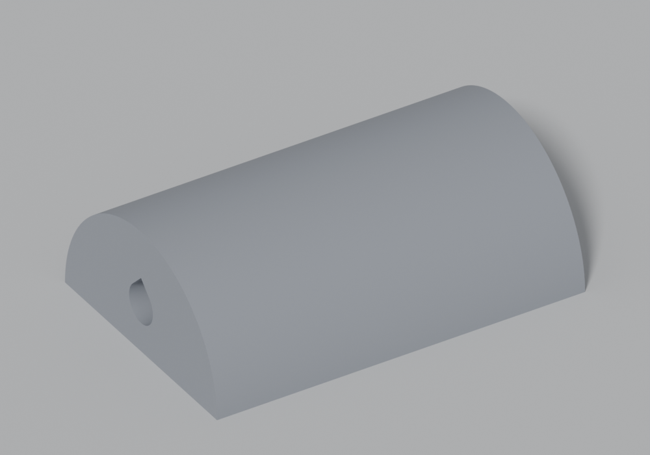
checklist/img/part_spigot_stub.png
