InMyPajamas/breadboard-bench/checklist/img/part_tie_stub.png

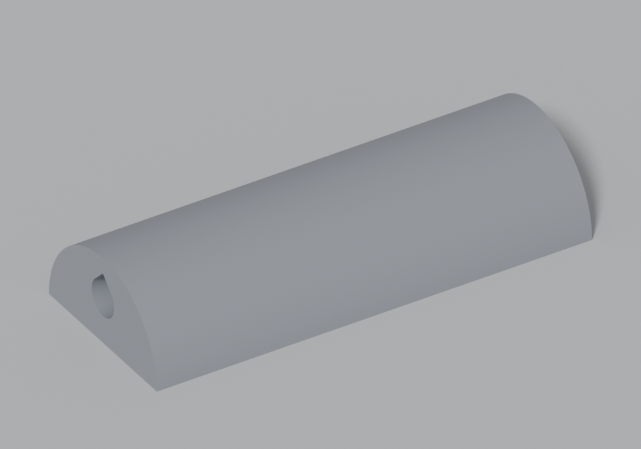
checklist/img/part_tie_stub.png
