InMyPajamas/breadboard-bench/checklist/img/part_tooth_gauge.png

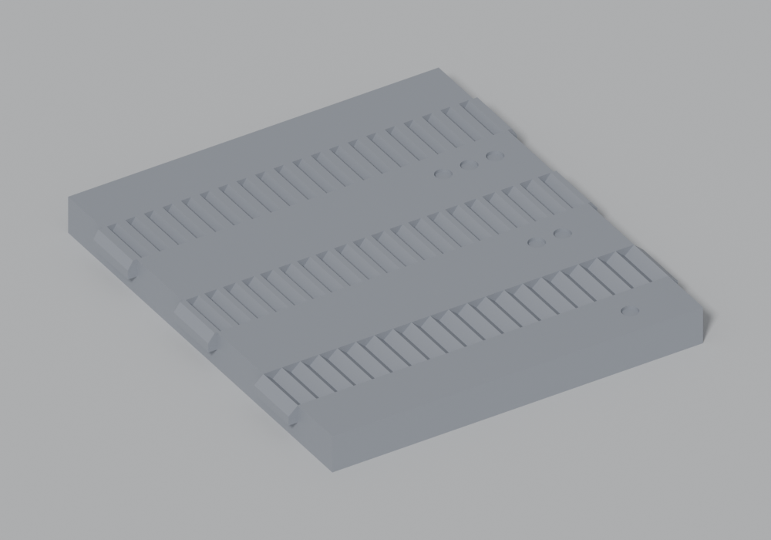
checklist/img/part_tooth_gauge.png
