InMyPajamas/breadboard-bench/checklist/img/rail_pad.png

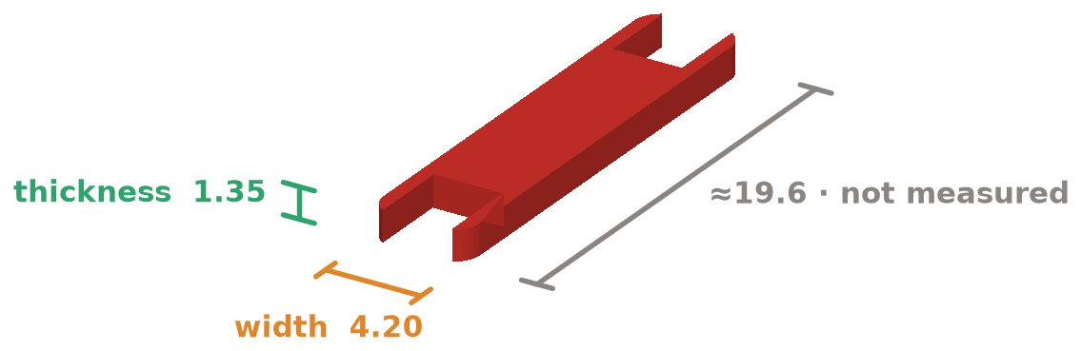
checklist/img/rail_pad.png
