InMyPajamas/breadboard-bench/checklist/img/tpu_block.png

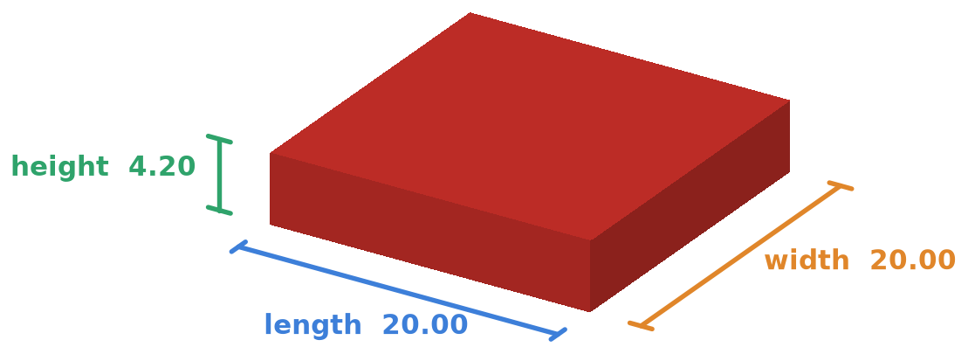
checklist/img/tpu_block.png
