InMyPajamas/breadboard-bench/docs/images/din_tilt.webp

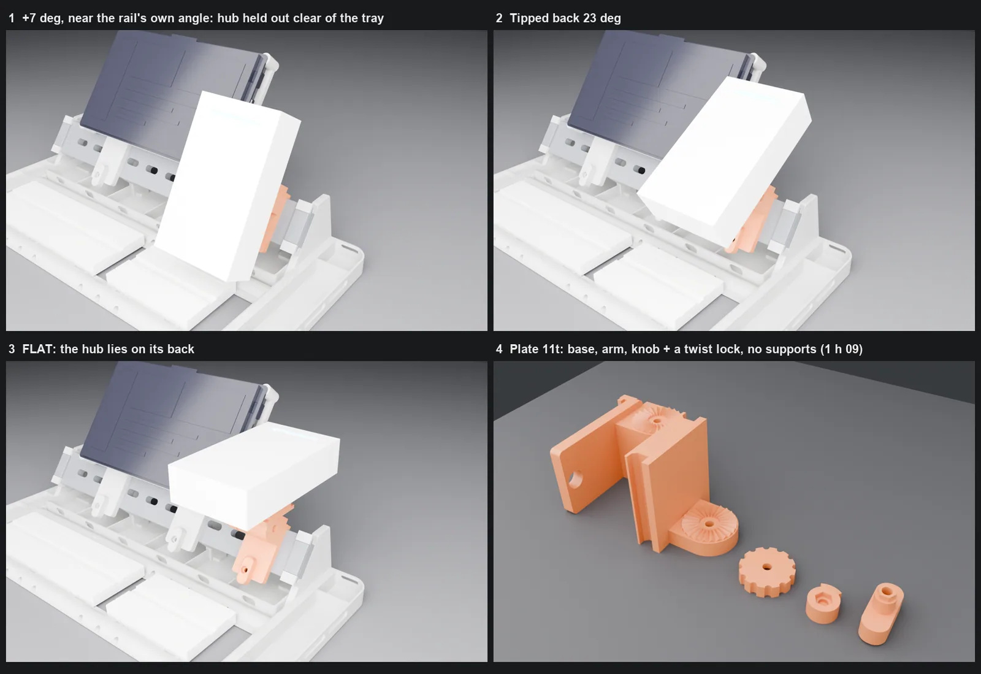
docs/images/din_tilt.webp
