InMyPajamas/breadboard-bench/out/plates/project_whole_bench.3mf

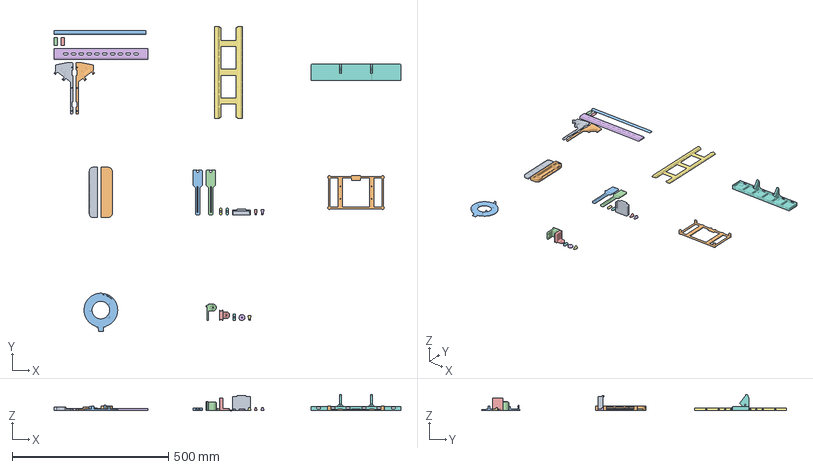
[picture p23: CAD file, 2026-10-17]
out/plates/project_whole_bench.3mf
1110.0 x 976.4 x 52.7 mm
end_frame
end_frame_r
rear_tie
rail_cap x 2
din_rail
deck_ladder
rear_tray
side_tray
side_bin
display_post x 2
display_lock x 3
display_lock_knob x 3
rail_bin
display_backplate
mic_crown
din_tilt_base
din_tilt_arm
din_tilt_knob
