InMyPajamas/breadboard-bench/out/plates/10c_mic_crown.3mf

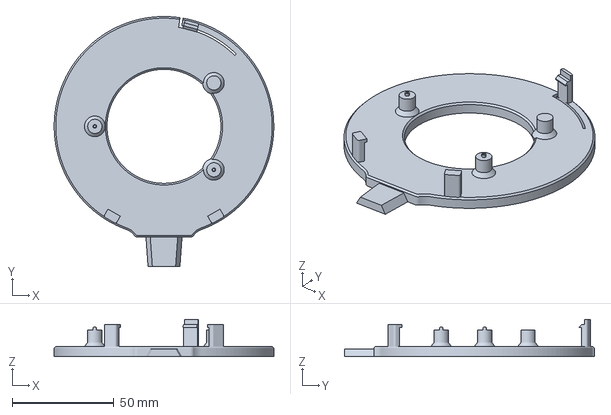
[picture p24: CAD file, 2026-10-17]
out/plates/10c_mic_crown.3mf
108.0 x 122.9 x 18.3 mm
