InMyPajamas/breadboard-bench/out/step/din_tilt_base.step

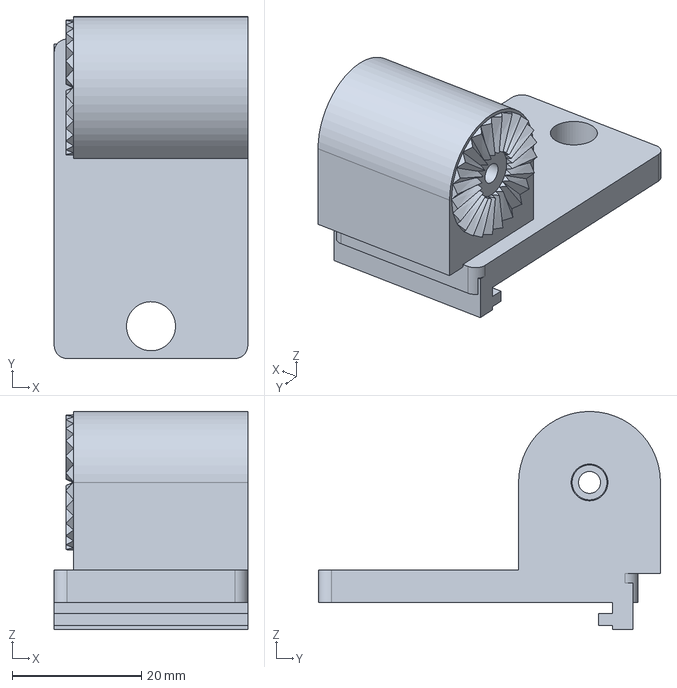
[picture p25: CAD file, 2026-10-17]
out/step/din_tilt_base.step
30.0 x 53.0 x 33.8 mm
