InMyPajamas/breadboard-bench/ref/templates/h2s_petg_hf_pla_basic.3mf

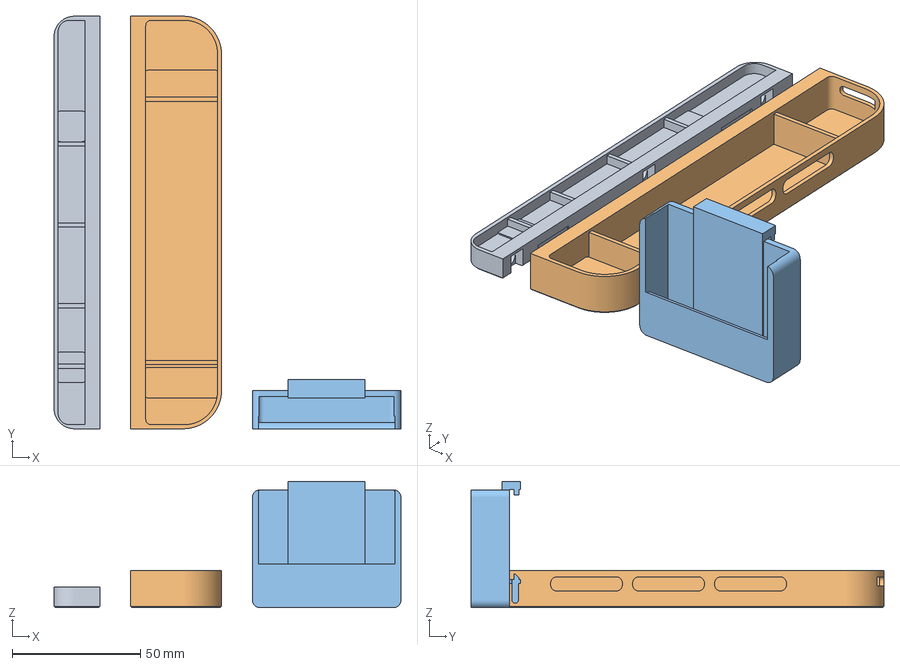
[picture p26: CAD file, 2026-10-17]
ref/templates/h2s_petg_hf_pla_basic.3mf
135.4 x 161.0 x 49.3 mm
side_tray
side_bin
rail_bin
