InMyPajamas/breadboard-bench/out/plates/02l_half_bay_gauge.3mf

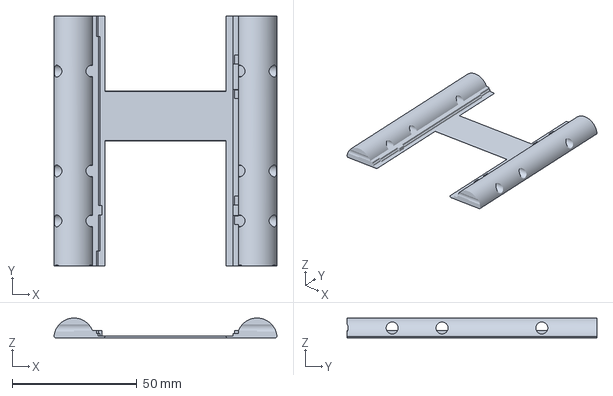
[picture p27: CAD file, 2026-10-17]
out/plates/02l_half_bay_gauge.3mf
89.4 x 100.0 x 8.00 mm
