InMyPajamas/breadboard-bench/out/step/screen_bezel.step

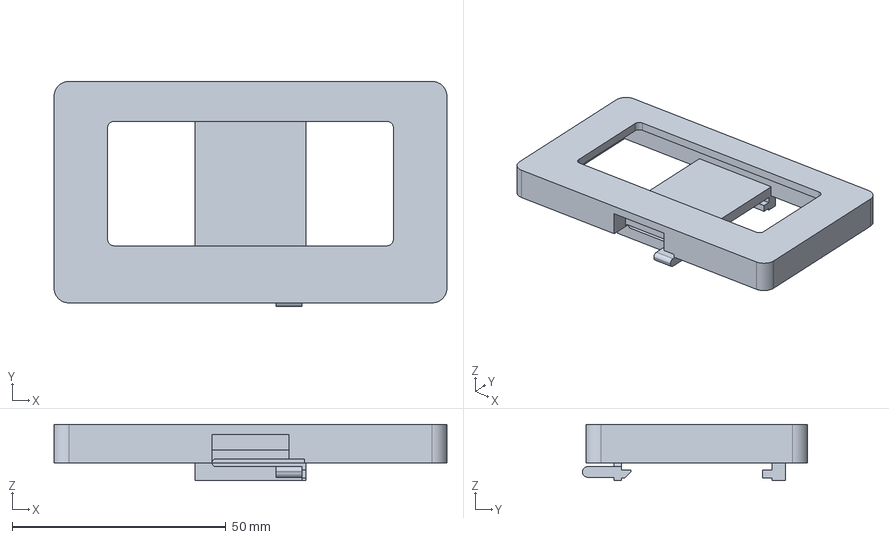
[picture p28: CAD file, 2026-10-17]
out/step/screen_bezel.step
92.0 x 52.7 x 13.2 mm
