InMyPajamas/breadboard-bench/out/plates/10d_display_backplate.3mf

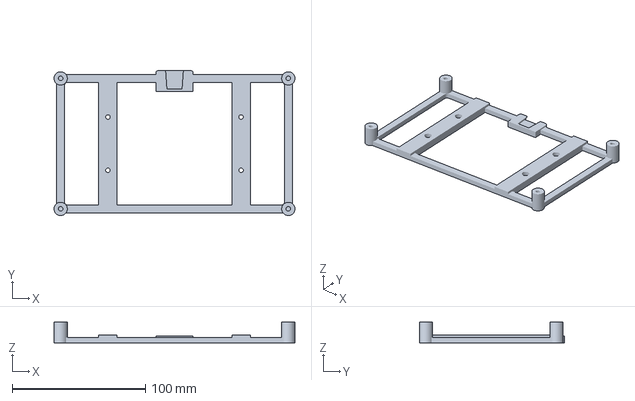
[picture p29: CAD file, 2026-10-17]
out/plates/10d_display_backplate.3mf
181.0 x 109.0 x 15.5 mm
