InMyPajamas/breadboard-bench/out/step/base_body.step

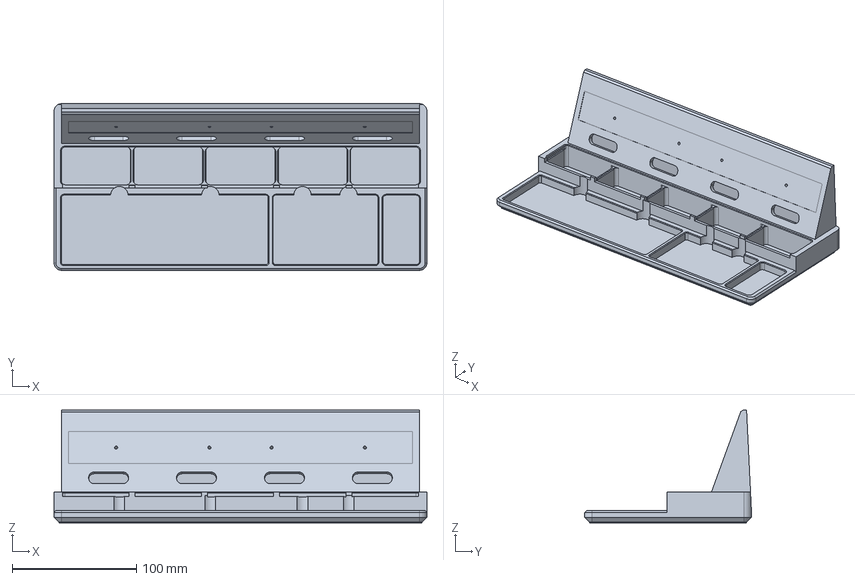
[picture p30: CAD file, 2026-10-17]
out/step/base_body.step
300.0 x 134.0 x 90.8 mm
