InMyPajamas/breadboard-bench/out/plates/10p_display_posts_locks.3mf

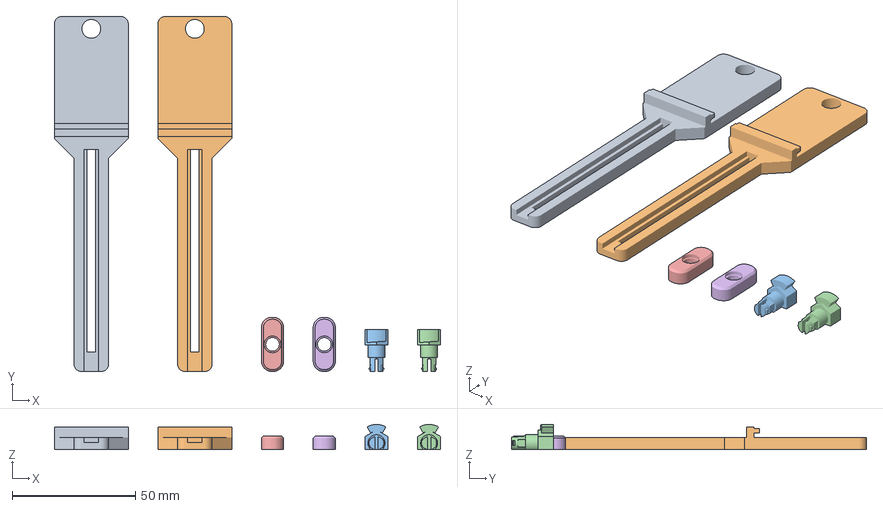
[picture p31: CAD file, 2026-10-17]
out/plates/10p_display_posts_locks.3mf
156.7 x 144.0 x 10.2 mm
display_post x 2
display_lock x 2
display_lock_knob x 2
