InMyPajamas/breadboard-bench/out/step/board_plate_pi.step

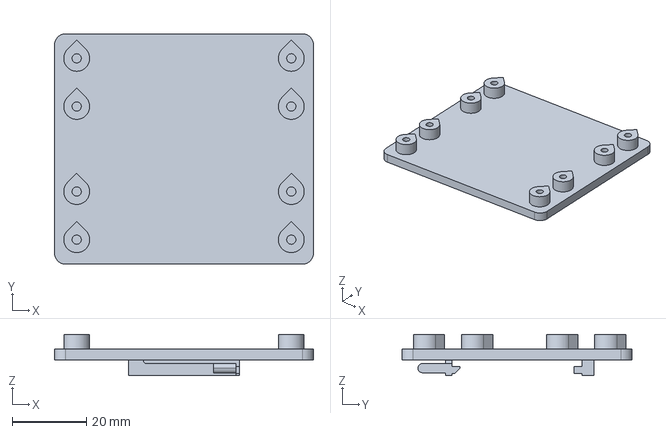
[picture p32: CAD file, 2026-10-17]
out/step/board_plate_pi.step
70.0 x 62.2 x 11.2 mm
