InMyPajamas/breadboard-bench/out/plates/07_deck_ladder.3mf

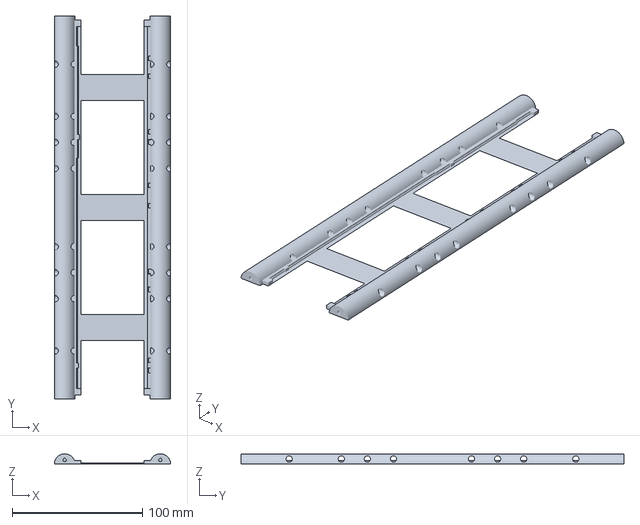
[picture p33: CAD file, 2026-10-17]
out/plates/07_deck_ladder.3mf
89.4 x 294.0 x 8.00 mm
