InMyPajamas/breadboard-bench/out/step/display_backplate.step

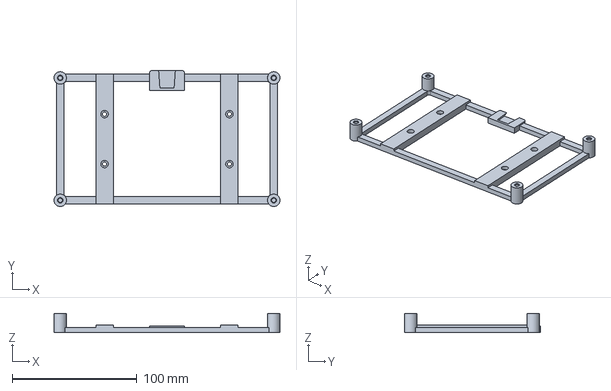
[picture p34: CAD file, 2026-10-17]
out/step/display_backplate.step
181.0 x 109.0 x 15.5 mm
