InMyPajamas/breadboard-bench/out/plates/05_right_frame.3mf

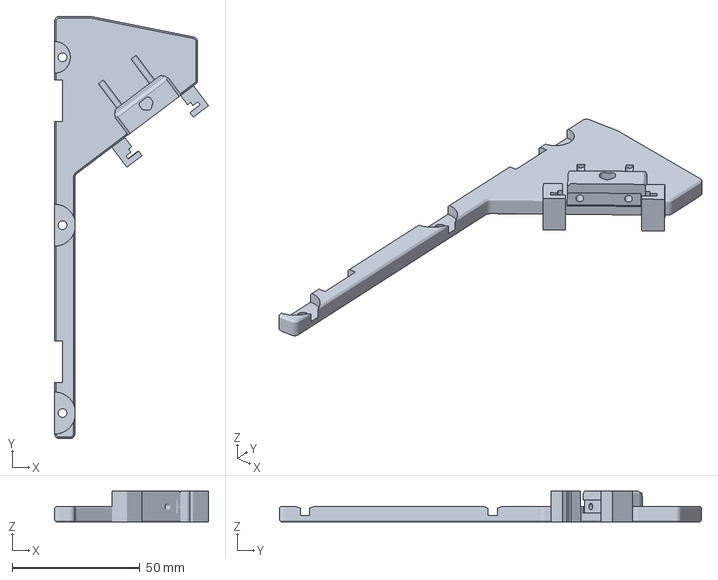
[picture p35: CAD file, 2026-10-17]
out/plates/05_right_frame.3mf
60.2 x 165.0 x 12.0 mm
