InMyPajamas/breadboard-bench/out/step/display_lock_knob.step

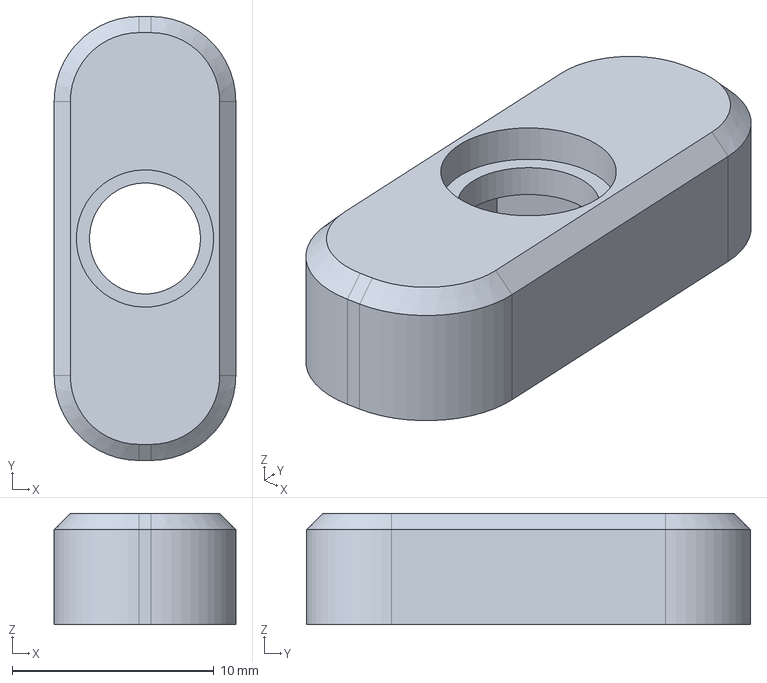
[picture p36: CAD file, 2026-10-17]
out/step/display_lock_knob.step
9.00 x 22.0 x 5.50 mm
