InMyPajamas/breadboard-bench/out/plates/07f_tpu_feet_all.3mf

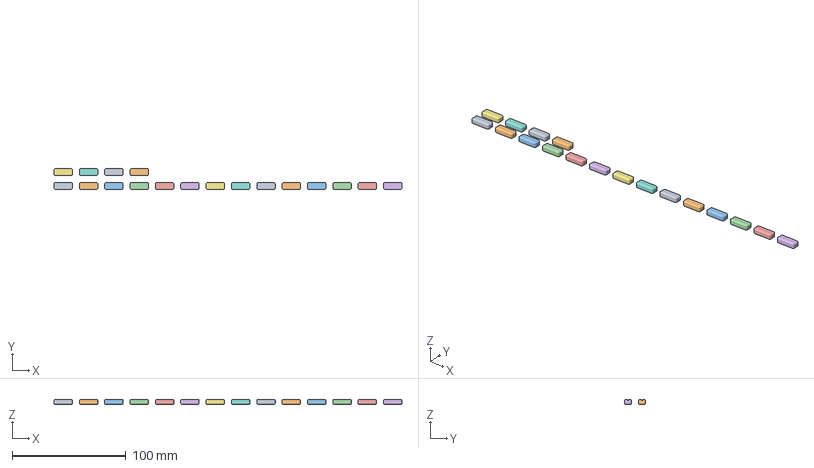
[picture p37: CAD file, 2026-10-17]
out/plates/07f_tpu_feet_all.3mf
305.4 x 18.5 x 4.20 mm
foot_pad x 18
