InMyPajamas/breadboard-bench/out/step/board_plate_esp.step

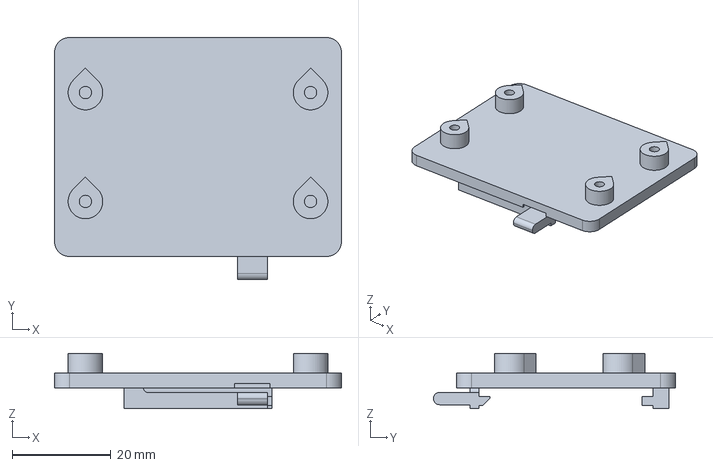
[picture p38: CAD file, 2026-10-17]
out/step/board_plate_esp.step
58.0 x 48.9 x 11.2 mm
