InMyPajamas/breadboard-bench/out/plates/09c_petg_clip_parts.3mf

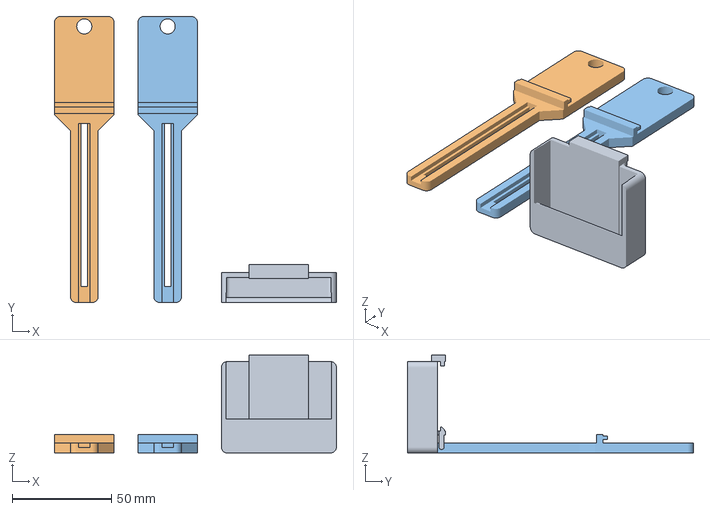
[picture p39: CAD file, 2026-10-17]
out/plates/09c_petg_clip_parts.3mf
142.0 x 144.0 x 49.3 mm
rail_bin
display_post x 2
