InMyPajamas/breadboard-bench/out/step/display_lock.step

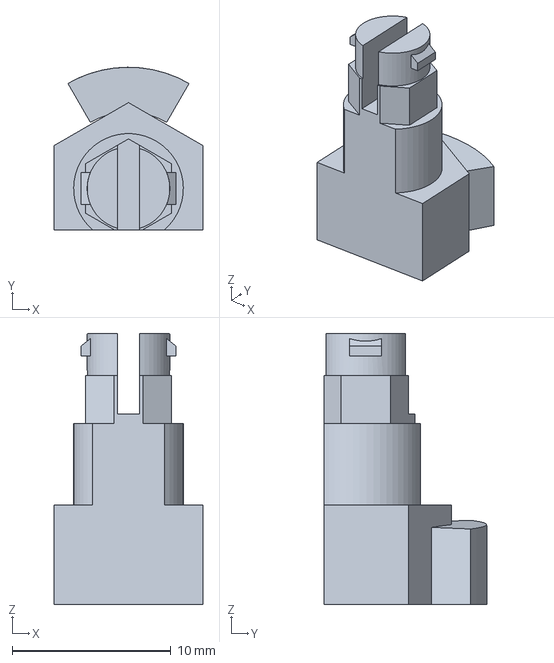
[picture p40: CAD file, 2026-10-17]
out/step/display_lock.step
9.35 x 10.2 x 17.1 mm
