InMyPajamas/breadboard-bench/out/plates/02c_oring_pilot_block.3mf

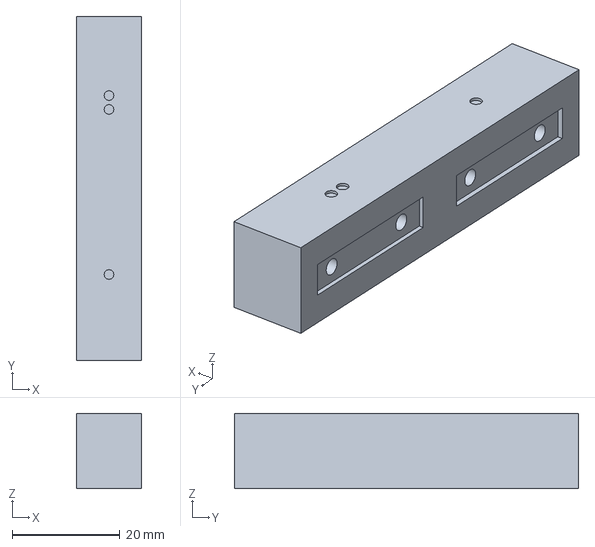
[picture p41: CAD file, 2026-10-17]
out/plates/02c_oring_pilot_block.3mf
12.0 x 64.0 x 14.0 mm
