InMyPajamas/breadboard-bench/out/step/display_post.step

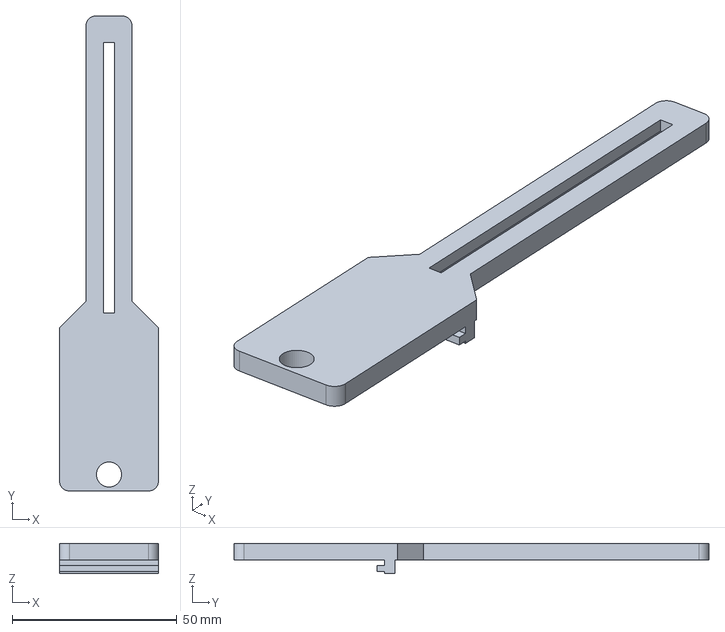
[picture p42: CAD file, 2026-10-17]
out/step/display_post.step
30.0 x 144.0 x 9.20 mm
