InMyPajamas/breadboard-bench/out/plates/02k_ledge_gauge.3mf

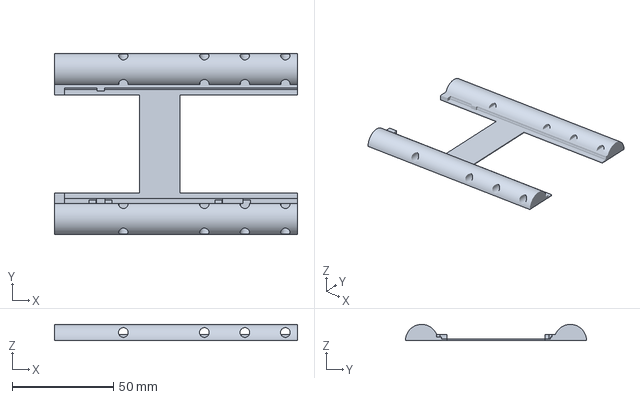
[picture p43: CAD file, 2026-10-17]
out/plates/02k_ledge_gauge.3mf
120.0 x 89.4 x 8.00 mm
