InMyPajamas/breadboard-bench/out/step/display_upright.step

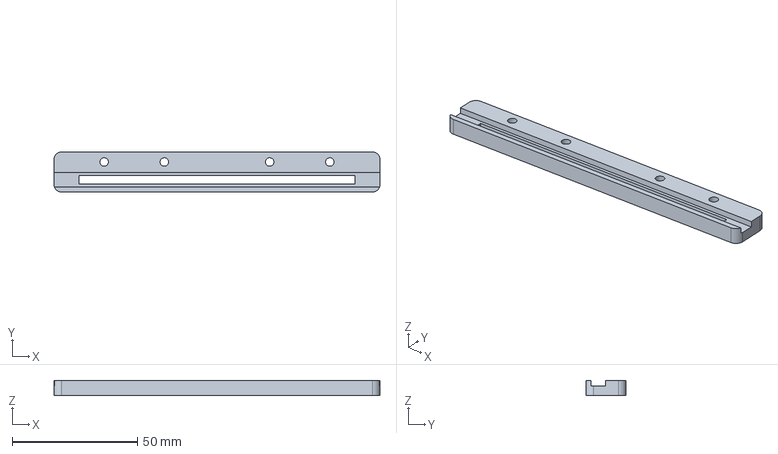
[picture p44: CAD file, 2026-10-17]
out/step/display_upright.step
130.0 x 16.0 x 6.00 mm
