InMyPajamas/breadboard-bench/out/plates/04_first_article_a.3mf

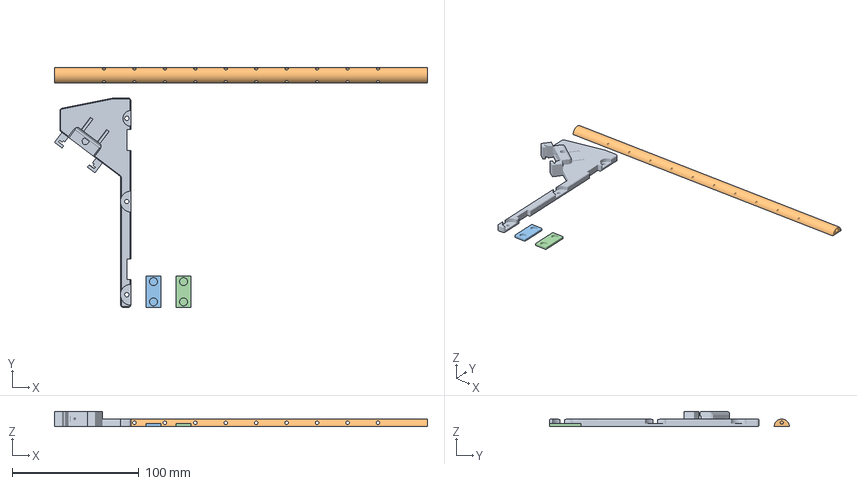
[picture p45: CAD file, 2026-10-17]
out/plates/04_first_article_a.3mf
294.0 x 189.0 x 12.0 mm
end_frame
rear_tie
rail_cap x 2
