InMyPajamas/breadboard-bench/out/step/display_spine.step

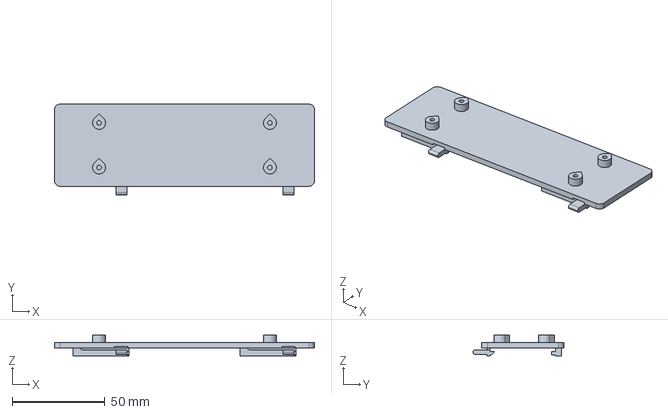
[picture p46: CAD file, 2026-10-17]
out/step/display_spine.step
140.0 x 48.9 x 11.2 mm
