InMyPajamas/breadboard-bench/out/step/display_crossbar.step

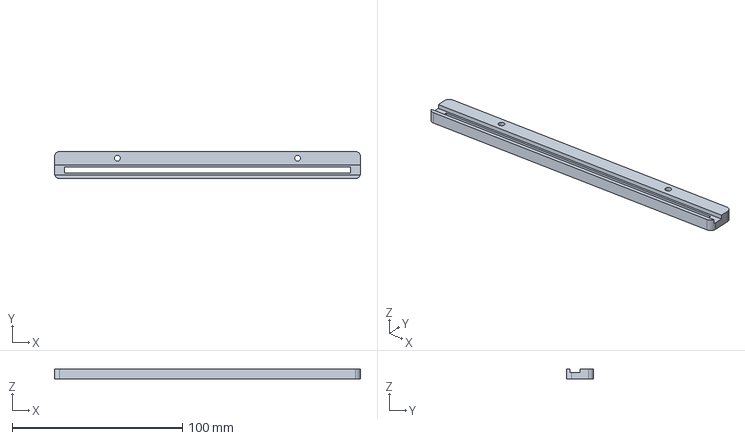
[picture p47: CAD file, 2026-10-17]
out/step/display_crossbar.step
180.0 x 16.0 x 6.00 mm
