InMyPajamas/breadboard-bench/out/plates/02h_span_gauge.3mf

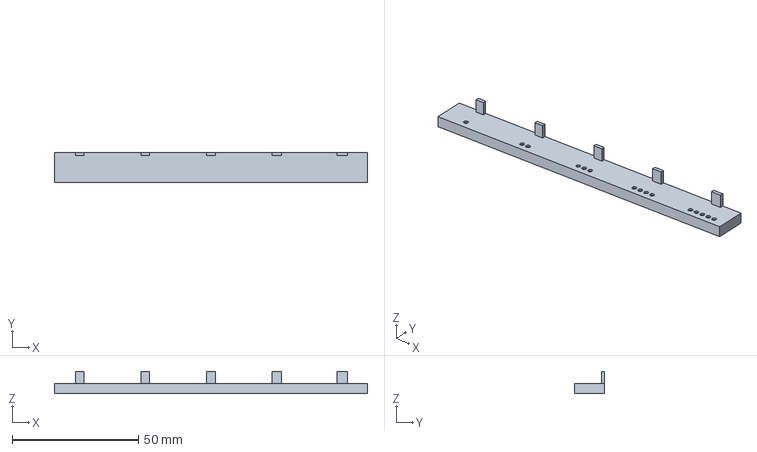
[picture p48: CAD file, 2026-10-17]
out/plates/02h_span_gauge.3mf
124.0 x 12.0 x 8.90 mm
