InMyPajamas/breadboard-bench/out/step/din_rail.step

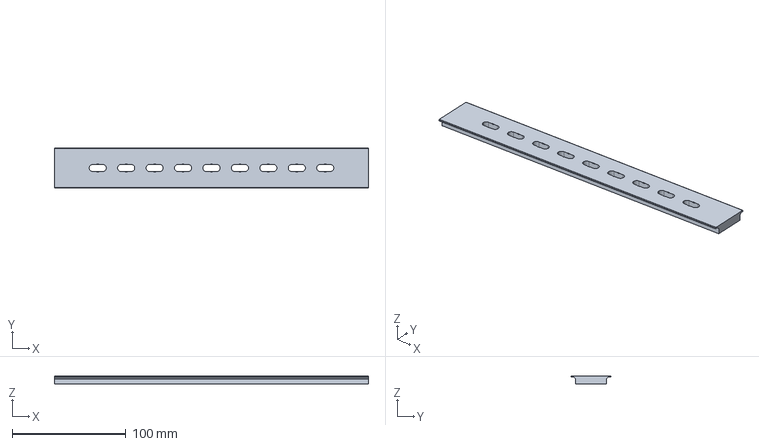
[picture p49: CAD file, 2026-10-17]
out/step/din_rail.step
276.0 x 34.9 x 7.40 mm
