InMyPajamas/breadboard-bench/out/plates/02r_rail_stub_clip_target.3mf

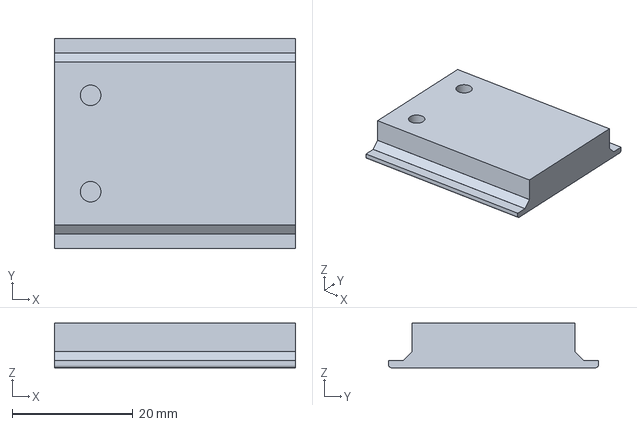
[picture p50: CAD file, 2026-10-17]
out/plates/02r_rail_stub_clip_target.3mf
40.0 x 34.8 x 7.40 mm
