InMyPajamas/breadboard-bench/out/step/din_tilt_knob.step

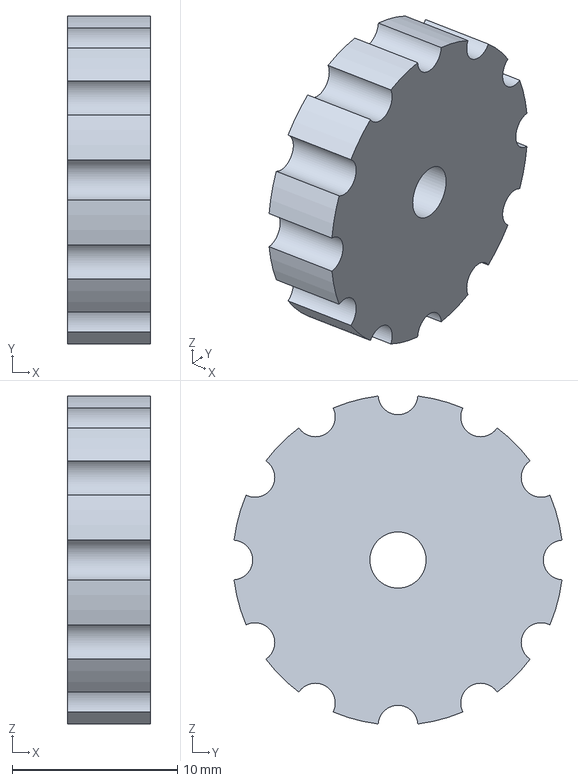
[picture p51: CAD file, 2026-10-17]
out/step/din_tilt_knob.step
5.00 x 19.9 x 19.9 mm
