InMyPajamas/breadboard-bench/out/plates/01_tpu_regime.3mf

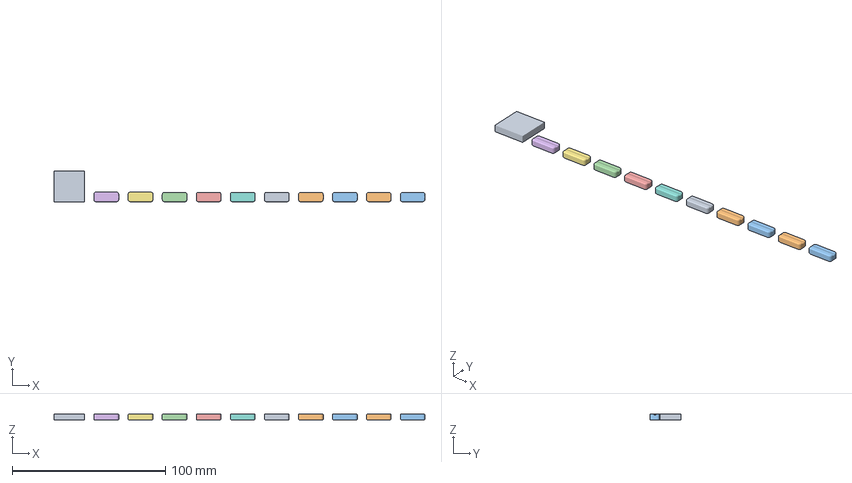
[picture p52: CAD file, 2026-10-17]
out/plates/01_tpu_regime.3mf
242.4 x 20.0 x 4.20 mm
tpu_block
foot_pad_006 x 2
foot_pad_012 x 2
foot_pad_018 x 2
foot_pad x 4
