InMyPajamas/breadboard-bench/out/step/din_tilt_arm.step

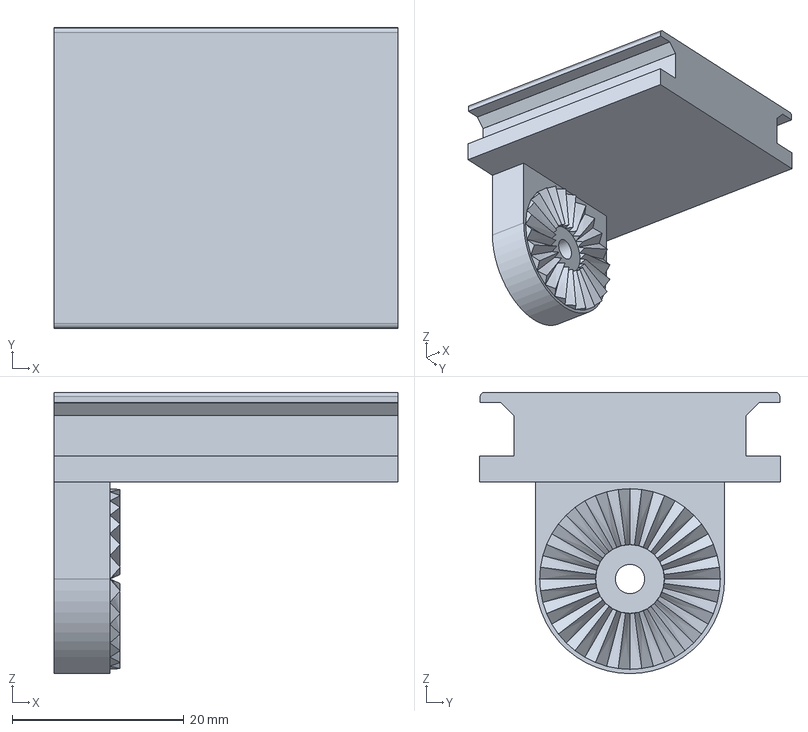
[picture p53: CAD file, 2026-10-17]
out/step/din_tilt_arm.step
40.0 x 35.0 x 32.7 mm
