InMyPajamas/breadboard-bench/out/plates/11t_din_tilt_adapter.3mf

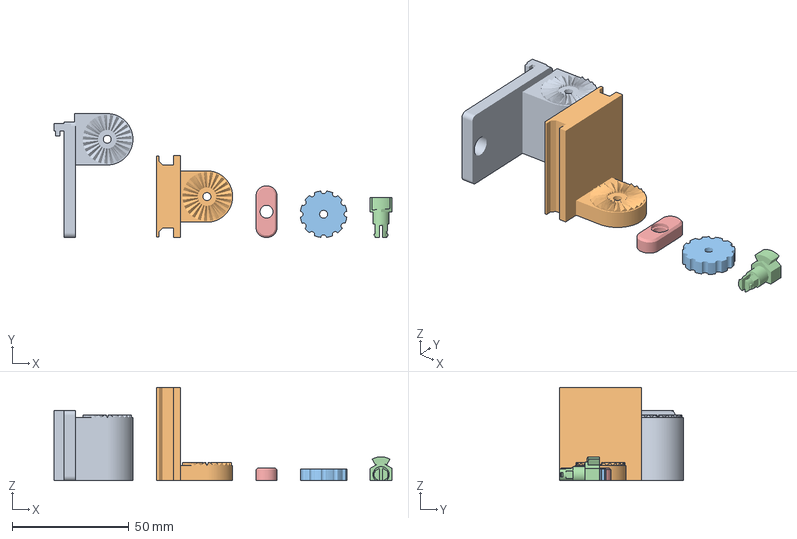
[picture p54: CAD file, 2026-10-17]
out/plates/11t_din_tilt_adapter.3mf
144.7 x 53.0 x 40.0 mm
din_tilt_base
din_tilt_arm
din_tilt_knob
display_lock
display_lock_knob
