InMyPajamas/breadboard-bench/out/step/breadboard_carrier.step

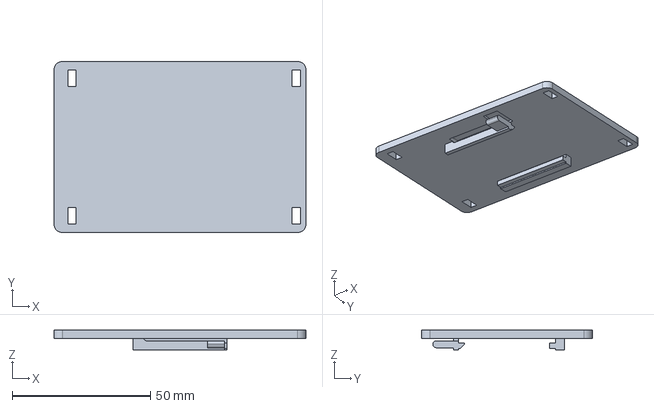
[picture p55: CAD file, 2026-10-17]
out/step/breadboard_carrier.step
91.0 x 61.8 x 7.20 mm
