InMyPajamas/breadboard-bench/out/plates/09_petg_side_parts.3mf

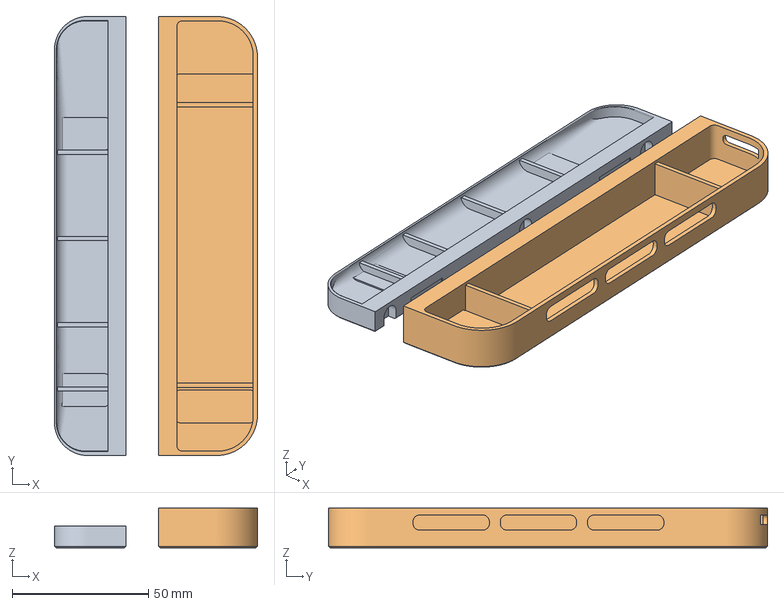
[picture p56: CAD file, 2026-10-17]
out/plates/09_petg_side_parts.3mf
74.5 x 161.0 x 14.5 mm
side_tray
side_bin
