InMyPajamas/breadboard-bench/out/step/rail_bin.step

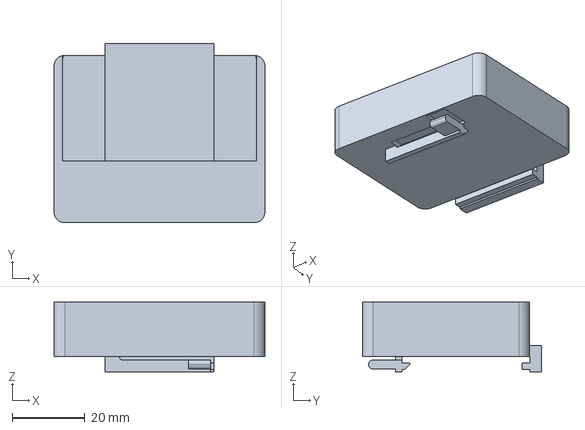
[picture p57: CAD file, 2026-10-17]
out/step/rail_bin.step
58.0 x 49.3 x 19.2 mm
