InMyPajamas/breadboard-bench/out/plates/02e_tooth_gauge.3mf

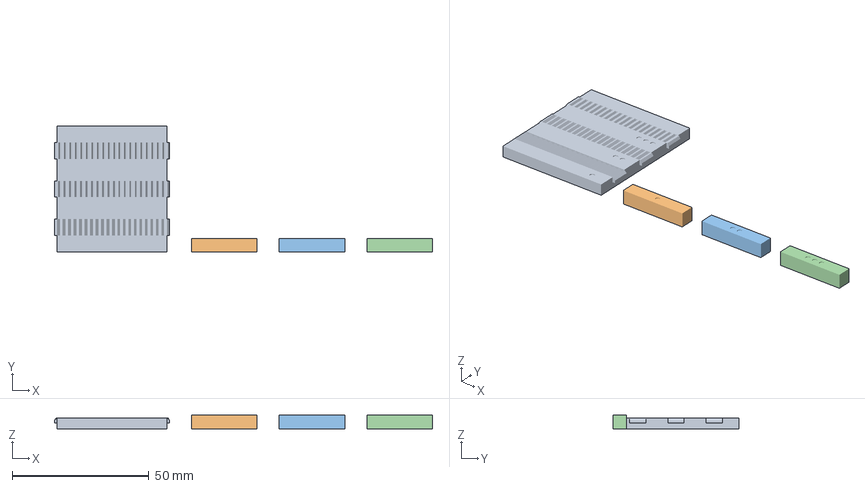
[picture p58: CAD file, 2026-10-17]
out/plates/02e_tooth_gauge.3mf
138.0 x 46.0 x 5.00 mm
tooth_gauge
tooth_rider_1
tooth_rider_2
tooth_rider_3
