InMyPajamas/breadboard-bench/out/plates/project_screen_mic_din.3mf

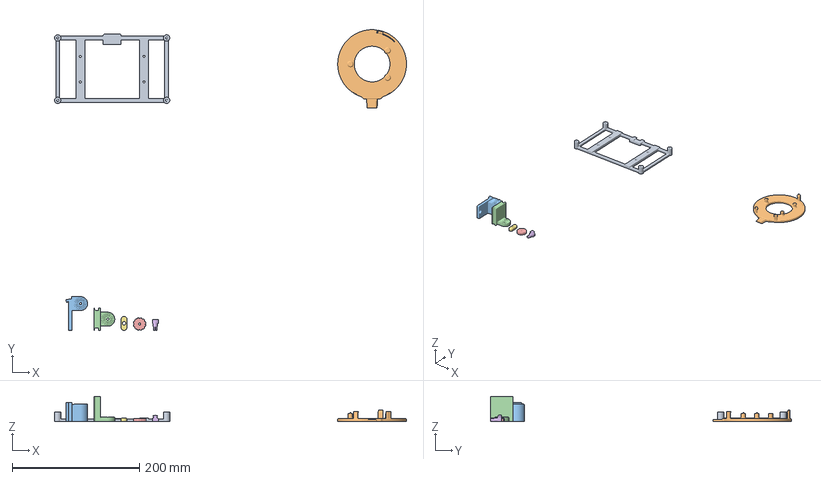
[picture p59: CAD file, 2026-10-17]
out/plates/project_screen_mic_din.3mf
552.5 x 471.9 x 40.0 mm
display_backplate
mic_crown
din_tilt_base
din_tilt_arm
din_tilt_knob
display_lock
display_lock_knob
