InMyPajamas/breadboard-bench/out/plates/02b_stub_and_foot_gauge.3mf

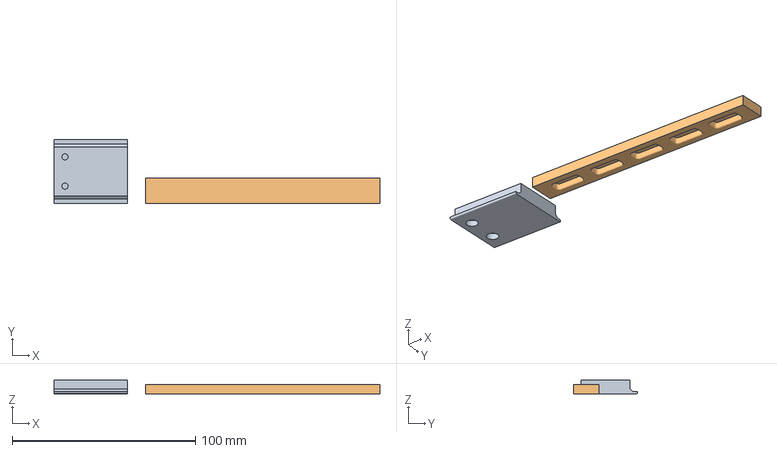
[picture p60: CAD file, 2026-10-17]
out/plates/02b_stub_and_foot_gauge.3mf
178.0 x 34.8 x 7.40 mm
rail_stub
foot_gauge_v2
