InMyPajamas/breadboard-bench/out/plates/04x_both_frames.3mf

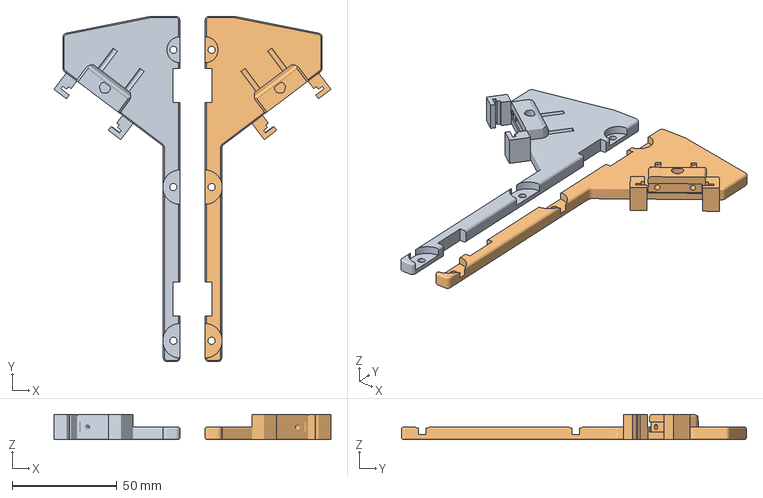
[picture p61: CAD file, 2026-10-17]
out/plates/04x_both_frames.3mf
132.3 x 165.0 x 12.0 mm
end_frame
end_frame_r
