InMyPajamas/breadboard-bench/out/plates/08_rear_tray.3mf

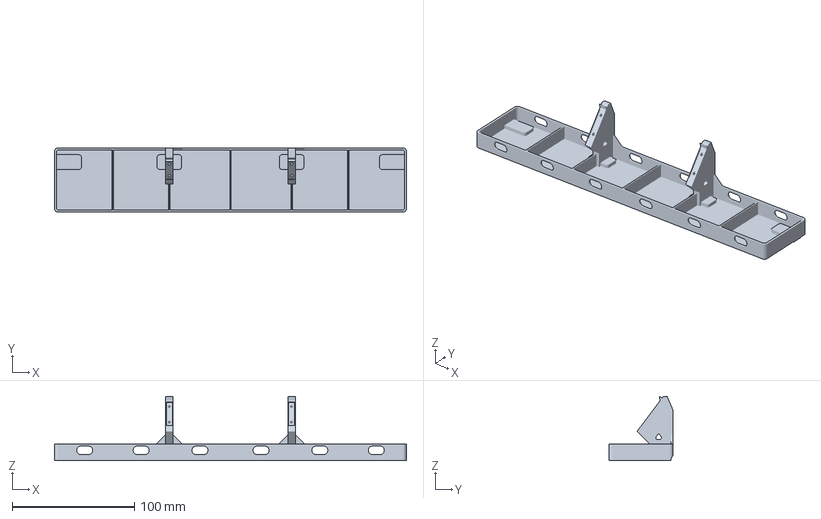
[picture p62: CAD file, 2026-10-17]
out/plates/08_rear_tray.3mf
288.0 x 52.7 x 52.7 mm
