InMyPajamas/breadboard-bench/out/plates/03c_clip_test.3mf

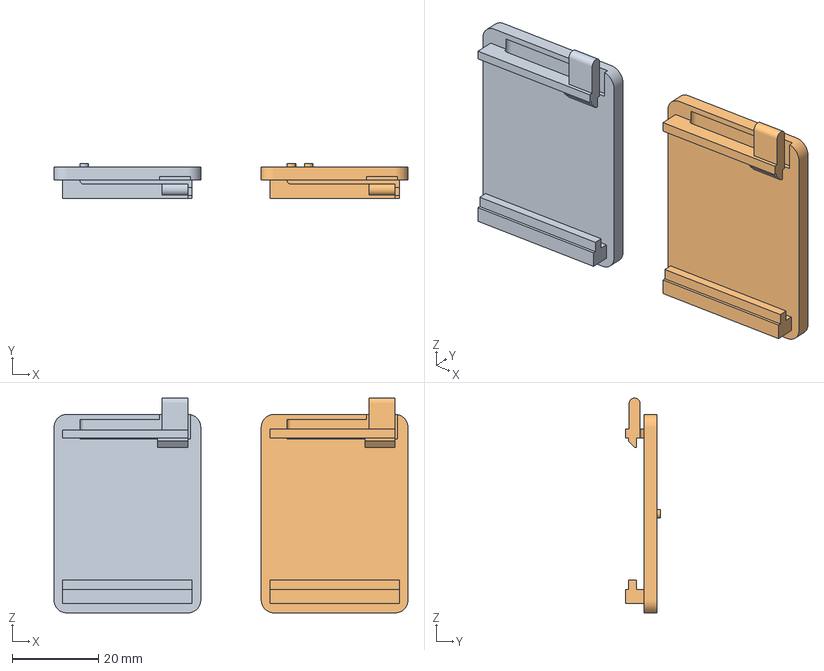
[picture p63: CAD file, 2026-10-17]
out/plates/03c_clip_test.3mf
82.0 x 8.00 x 49.8 mm
clip_test_18
clip_test_20
