InMyPajamas/breadboard-bench/out/plates/03_petg_gauges.3mf

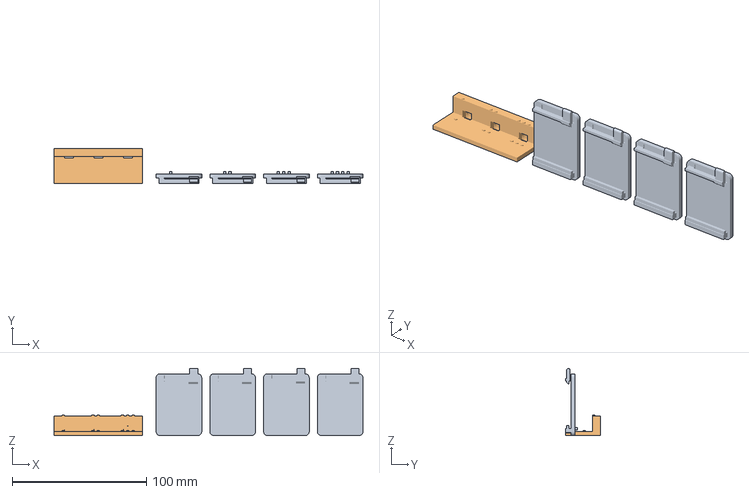
[picture p64: CAD file, 2026-10-17]
out/plates/03_petg_gauges.3mf
230.0 x 26.0 x 50.0 mm
fit_clips_petg
magnet_gauge
