InMyPajamas/breadboard-bench/out/plates/02g_cradle_gauge.3mf

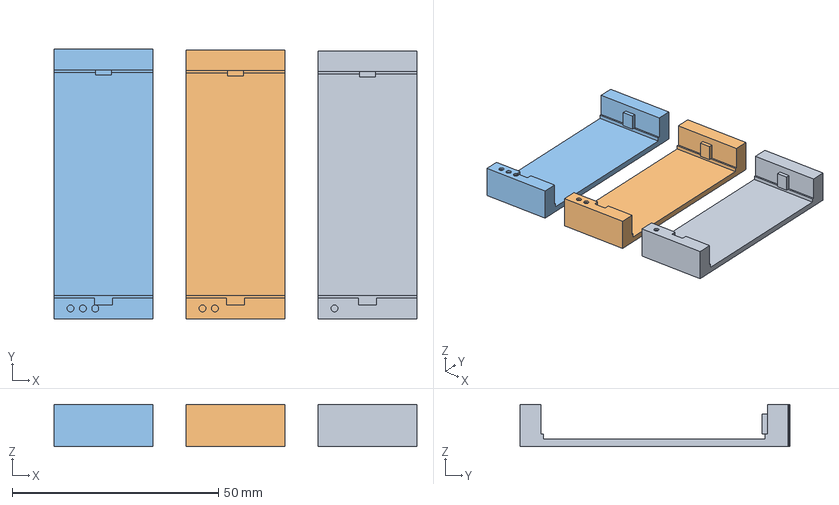
[picture p65: CAD file, 2026-10-17]
out/plates/02g_cradle_gauge.3mf
88.0 x 65.3 x 10.2 mm
cradle_gauge_1
cradle_gauge_2
cradle_gauge_3
