InMyPajamas/breadboard-bench/out/plates/02_pla_gauges.3mf

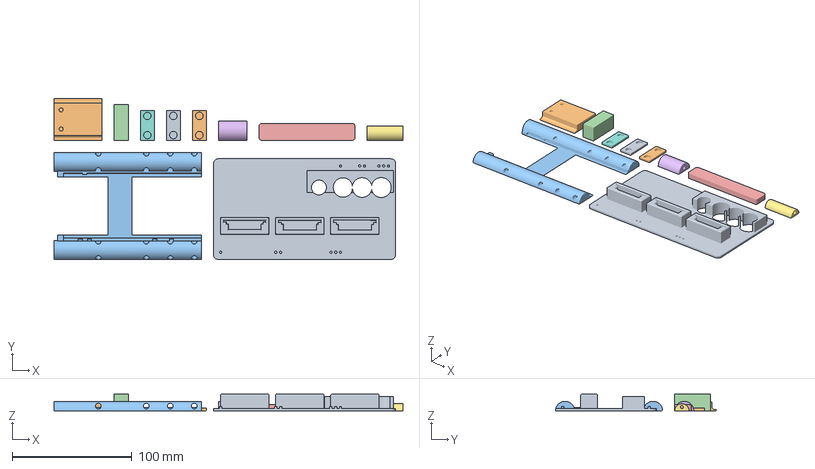
[picture p66: CAD file, 2026-10-17]
out/plates/02_pla_gauges.3mf
291.1 x 134.2 x 14.0 mm
fit_coupon_frame
rail_stub
ladder_station_stub
pilot_block
foot_gauge
spigot_stub
tie_stub
rail_cap_615
rail_cap_625
rail_cap_635
