InMyPajamas/breadboard-bench/out/plates/02i_cleat_rework.3mf

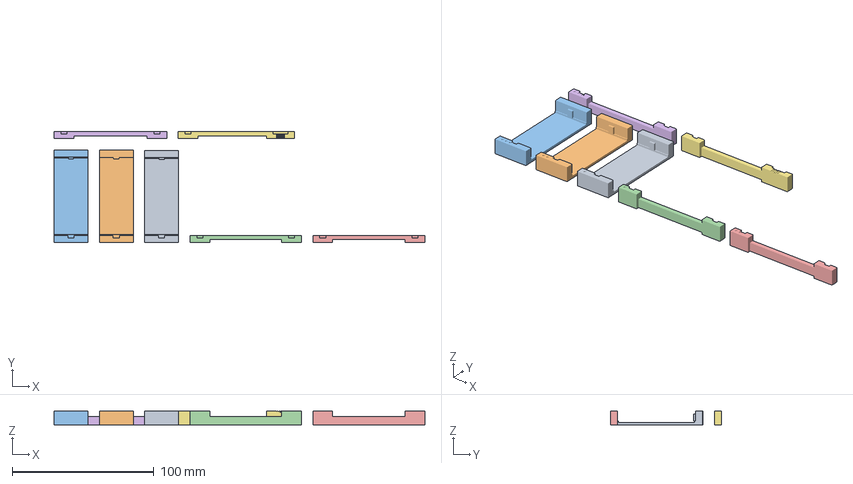
[picture p67: CAD file, 2026-10-17]
out/plates/02i_cleat_rework.3mf
261.9 x 78.3 x 10.2 mm
cradle_gauge_1
cradle_gauge_2
cradle_gauge_3
span_gauge_1
span_gauge_2
span_gauge_3
span_gauge_slot
