InMyPajamas/breadboard-bench/out/plates/06x_pla_structure_one_plate.3mf

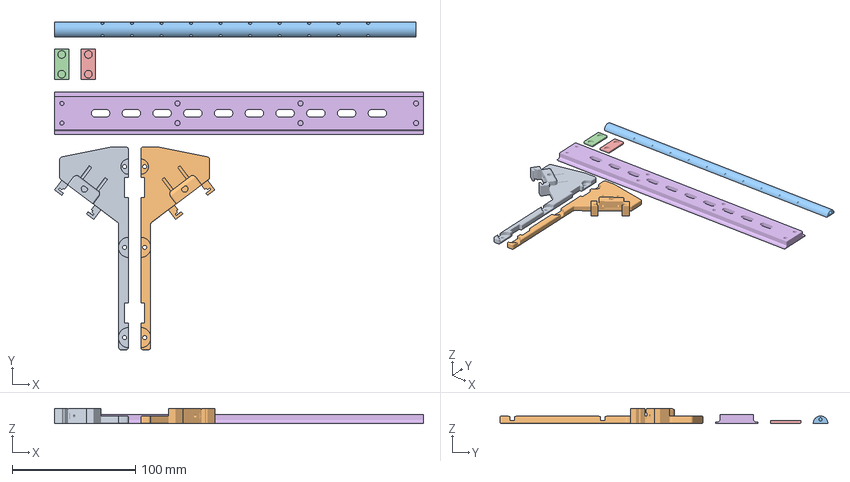
[picture p68: CAD file, 2026-10-17]
out/plates/06x_pla_structure_one_plate.3mf
300.0 x 266.5 x 12.0 mm
end_frame
end_frame_r
rear_tie
rail_cap x 2
din_rail
