InMyPajamas/breadboard-bench/out/plates/02f_slot_gauge.3mf

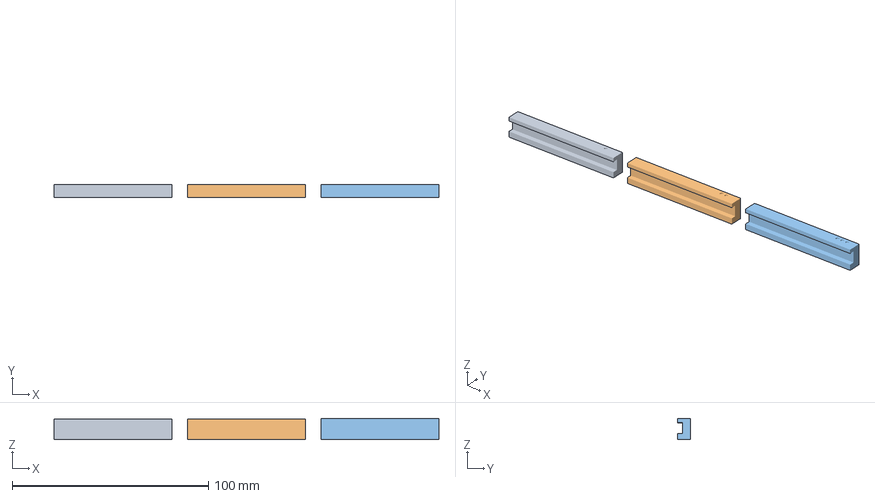
[picture p69: CAD file, 2026-10-17]
out/plates/02f_slot_gauge.3mf
196.0 x 6.49 x 10.8 mm
slot_gauge_1
slot_gauge_2
slot_gauge_3
