InMyPajamas/breadboard-bench/out/plates/06_din_rail.3mf

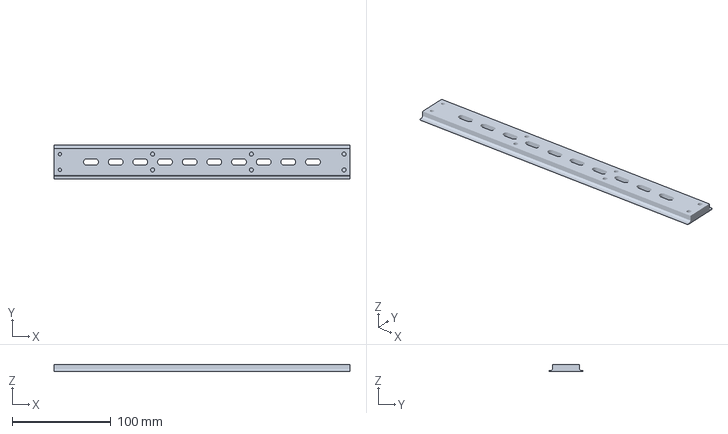
[picture p70: CAD file, 2026-10-17]
out/plates/06_din_rail.3mf
300.0 x 34.8 x 7.40 mm
