InMyPajamas/breadboard-bench/out/plates/02d_deck_pair.3mf

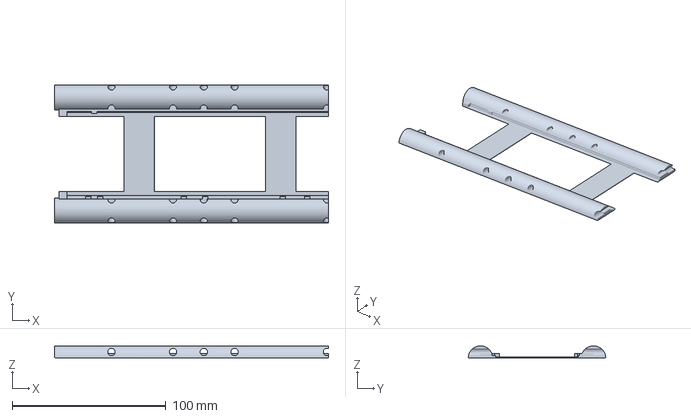
[picture p71: CAD file, 2026-10-17]
out/plates/02d_deck_pair.3mf
178.0 x 89.4 x 8.00 mm
