InMyPajamas/breadboard-bench/out/plates/07c_tpu_pads_side_parts.3mf

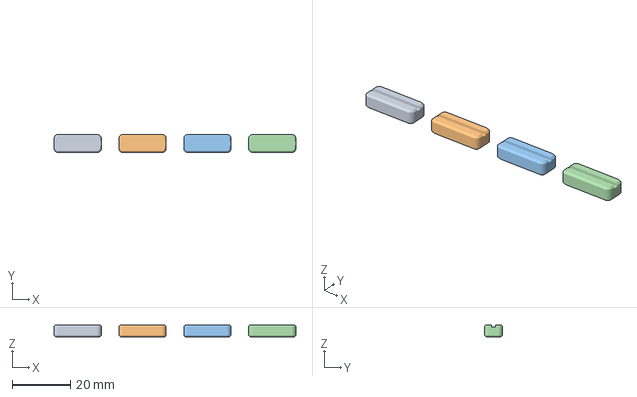
[picture p72: CAD file, 2026-10-17]
out/plates/07c_tpu_pads_side_parts.3mf
83.0 x 6.24 x 4.20 mm
foot_pad x 4
