InMyPajamas/breadboard-bench/out/plates/02m_cal_target.3mf

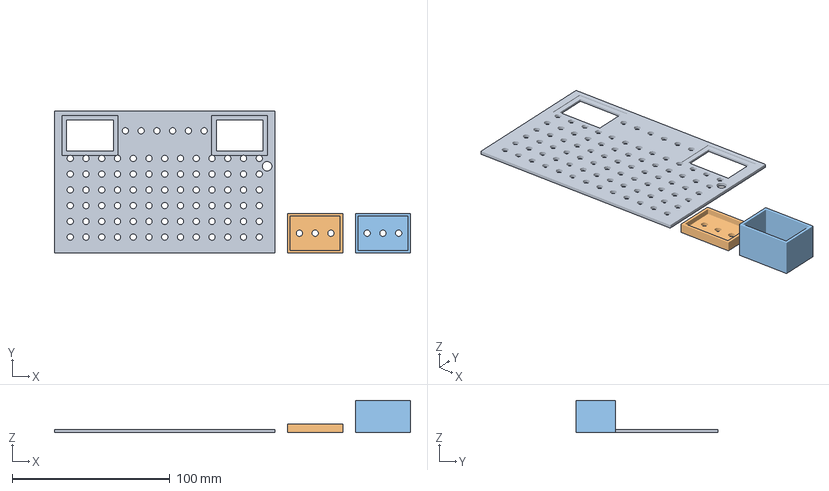
[picture p73: CAD file, 2026-10-17]
out/plates/02m_cal_target.3mf
226.0 x 90.0 x 20.6 mm
cal_target
cal_step5
cal_step20
