InMyPajamas/breadboard-bench/out/plates/02j_span_recut.3mf

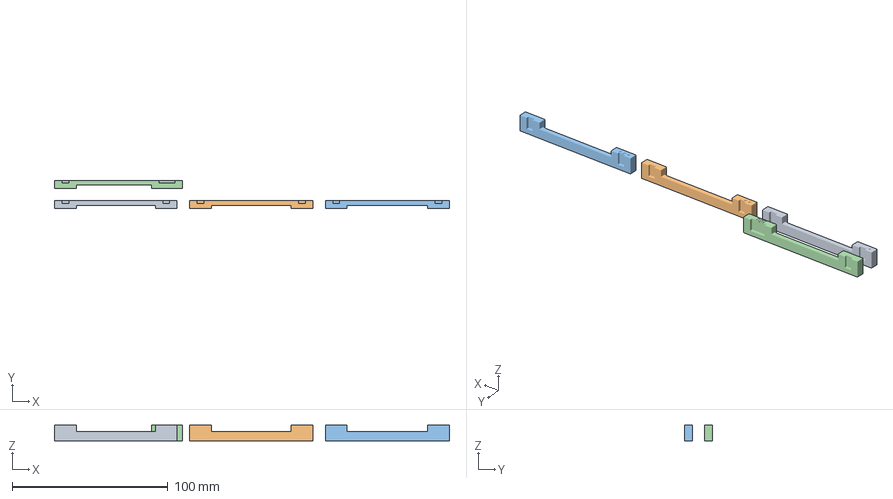
[picture p74: CAD file, 2026-10-17]
out/plates/02j_span_recut.3mf
253.6 x 18.0 x 10.2 mm
span_gauge_1
span_gauge_2
span_gauge_3
span_gauge_slot
