InMyPajamas/breadboard-bench/out/plates/07b_tpu_pads_held.3mf

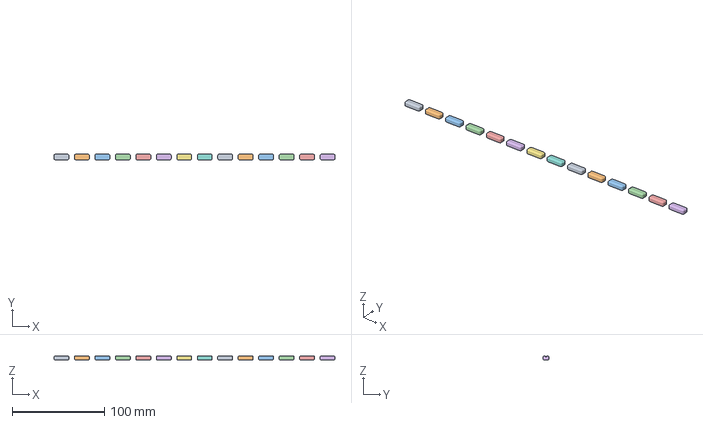
[picture p75: CAD file, 2026-10-17]
out/plates/07b_tpu_pads_held.3mf
305.4 x 6.24 x 4.20 mm
foot_pad x 14
