InMyPajamas/breadboard-bench/out/plates/10m_buried_magnet_coupons.3mf

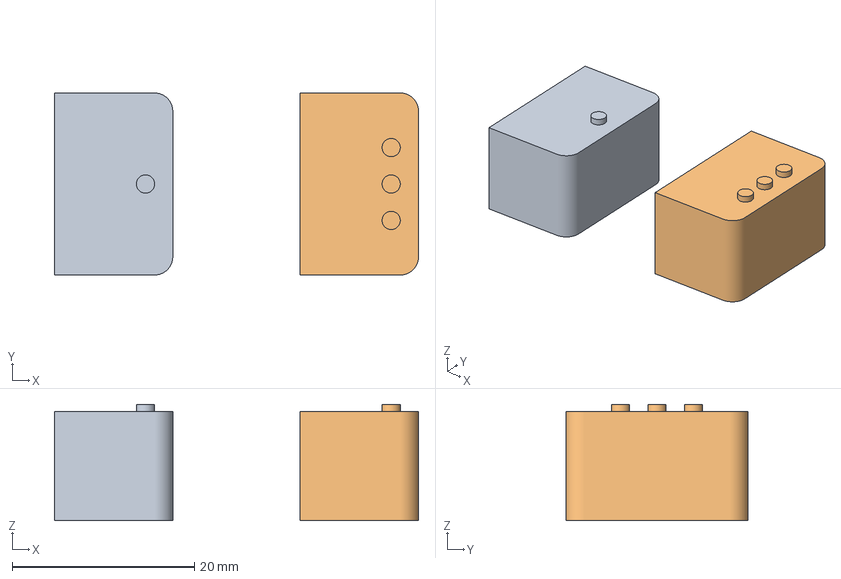
[picture p76: CAD file, 2026-10-17]
out/plates/10m_buried_magnet_coupons.3mf
40.0 x 20.0 x 12.8 mm
skin_coupon_045
skin_coupon_085
