InMyPajamas/breadboard-bench/(list of files, cad)

Other CAD files:
out/step/mic_crown.step
out/plates/09p_display_post.3mf
out/plates/10L_twist_locks_screwless.3mf
