InMyPajamas/breadboard-bench/(commit log)

2026-10-17 Breadboard Bench: parametric CAD, checks, Bambu Studio plates and the build hub
    Every part is build123d code (cad/bench.py, cad/frame.py) driven by
    cad/params.py. check.py, screws.py and assembly_fit_check.py gate each
    change; plates.py writes the Bambu Studio projects, including the whole
    bench as one eight-plate project (out/plates/project_whole_bench.3mf) and
    the TPU feet (out/plates/07f_tpu_feet_all.3mf).
    [01_tpu_regime.3mf, 02_pla_gauges.3mf, 02b_stub_and_foot_gauge.3mf, 02c_oring_pilot_block.3mf, 02d_deck_pair.3mf, 02e_tooth_gauge.3mf, 02f_slot_gauge.3mf, 02g_cradle_gauge.3mf]
2026-10-17 Mobile: clear the 3D viewer's touch area, give it most of a phone screen, stop sideways scrolling
    The viewer's stat block covered the stage on phones; it now moves into the
    rail under the title, the stage takes 64% of the screen, and a touch hint
    fades at the first touch. The hub gives the viewer 78% of a phone screen
    and an Open full screen link. Wide tables scroll inside themselves and
    plan rows drop two columns, so no tab scrolls sideways at 390 px. The
    viewer's envelope is now read from its data, and it declares UTF-8.
2026-10-17 Optional add-ons: DIN tilt adapter in the 3D viewer, Studio project info
    The tilt adapter (with a UniFi-sized device at its flat stop) is placed at
    the rail's right end in out/frame_addons and shown in the 3D viewer behind
    an 'Optional: DIN tilt adapter' switch that swaps out the rail bin. The
    Bambu projects now fill Studio's Project tab (title, description, plates,
    hardware, pictures, a parts list and the plate guide) and mark plates 7
    and 8 optional. Plate names avoid the characters Studio rejects.
    [01_tpu_regime.3mf, 02_pla_gauges.3mf, 02b_stub_and_foot_gauge.3mf, 02c_oring_pilot_block.3mf, 02d_deck_pair.3mf, 02e_tooth_gauge.3mf, 02f_slot_gauge.3mf, 02g_cradle_gauge.3mf]
